etonealbert/frontier-navara-alaskan-latch/INPUT_SHA256.md

# Input SHA-256 checksums

- `input/cad-latch-spec.md` (original Russian specification): `16639eb333ce7da3cb17c0e53108751b8e13a31392efb1666b8e538bc34eb55a`
- `input/cad-photo-atlas.pdf` (English edition supplied by the owner): `2da166d66fd484453dd131d62949d49e78a3da9dffdf473839794cafe3c26b40`

The preceding Russian atlas is available in Git history. Its original ten embedded photos are pixel-identical to the photos on pages 2–11 of the English edition.
