etonealbert/frontier-navara-alaskan-latch/reports/assumptions.md

# Допущения и неподтверждённые зоны V01

V01 — **предварительная модель для примерки**, а не метрологическая копия. Все значения со статусами О, Д и ?
редактируются в [`src/params.py`](../src/params.py); полный автоматически сгенерированный список параметров
со статусами и источниками — [parameters.md](./parameters.md). Измеренные значения тела — [validation.md](./validation.md).

Статусы ТЗ: **У** — владелец; **И** — исходное описание; **О** — оценка; **Д** — допущение; **Р** — расчёт; **?** — неизвестно.

## Редакции

| Дата | Изменение | Основание |
|---|---|---|
| 12.11.2026 | Первая полная модель V01 | ТЗ ред. 2, фотоальбом |
| 13.11.2026 | Отверстия проушин **Ø2,5 → Ø3,1**. По цепи ТЗ §4/§10.2 центр C опущен **7,15 → 6,85** над A (перемычка 2,9 над отверстием сохранена); дуга вершины ушка R4,15 → **R4,45**; развал боковин 8,4° → 6,4°. Остальная геометрия не менялась; зуб относительно C сместился на 0,30 вверх (ΔZ −23,79 → −23,49) | Исправленный замер владельца: прежний Ø2,5 неверен |

## 1. Базы и система координат

| Решение | Статус | Обоснование |
|---|---|---|
| X — ось C; Z — нормаль к A к макушкам проушин; H = Z; +Y — тыльная сторона (рожки, рёбра, зуб), −Y — лицевая (лопатка) | Д (ТЗ §2) | Правая тройка; начало — на A под осью C в плоскости симметрии B |
| A ∥ P (δ = 0°) | Д (ТЗ §2, §10.1) | На фото IMG_4396 линии площадки и лопатки различаются ≈2°; ТЗ задаёт 0° как стартовое |
| **S** — линия выхода верхней грани лопатки (плоскость P) из лицевой плоскости фланца; виртуальная острая кромка (в теле есть галтель R1) | Д (ТЗ §2 требует указать кромку) | Владелец мерил 30,0 «от ступеньки»; верхняя (лицевая) грань — естественная база замера |
| Положение S: 3,5 мм вдоль F от прямой кончиков крылышек (`PADDLE_S_V`) | О | По IMG_4396 и IMG_4391 получается 3,6–3,9; взято 3,5, чтобы корень лопатки 52 мм оставался внутри контура фланца |
| L1 = 30,0 — от S вдоль P до крайней точки свободного торца | У/Д | Как в ТЗ §2 |

## 2. Замыкание H1 и зависимая длина шейки

- H1 = 33,5 измеряется от макушки проушины (Z = 11,3) до **самой нижней точки фланца**. Фланец наклонён на 20°
  верхом к рожкам (+Y), поэтому в V01 нижняя точка — **тыльно-нижняя кромка фланца при X = 0** (со скруглением R0,4).
- Ведущий размер H1 сохраняется точно, поэтому **шейка — зависимое звено**: 3,42 мм по лицевой грани (от нижнего
  лицевого угла площадки до прямой V = 0) и 4,58 мм по тыльной грани — вместо стартовых 5,1 (ТЗ §10.2 разрешает это явно).
  Цепь: 11,3 + 2,5 + 3,42·cos20° + 16,5·cos20° + 3,2·sin20° − 0,11 (скругление) = 33,5.
- **Чувствительность.** На фото нижней кажется лицевая кромка (перспектива или пространственный изгиб, который ТЗ
  запрещает вводить). Если владелец мерил H1 до лицевой кромки, фланец должен стоять на ≈1,0 мм ниже, а шейка
  станет ≈4,5 мм по лицевой грани. **Подтвердить у владельца.**

## 3. Шейка и фланец

| Решение | Статус | Обоснование / последствия |
|---|---|---|
| Шейка и фланец — одна пластина: лицевая грань шейки продолжает лицевую грань фланца | Д | Так на IMG_4391/4396; требует β = α + δ (при иных углах построение останавливается с понятной ошибкой — излом шейки в V01 не реализован) |
| Толщина шейки = толщине фланца **3,2** (исходник: 3,0) | Д, отклонение +0,2 от И | Непрерывная литая пластина без видимой ступени; 0,2 мм ниже точности исходного замера; `NECK_THICKNESS_SPEC` сохранён для справки |
| Ширина шейки 32,68 у площадки → 34,0 у прямой V = 0 (линейно); вогнутые переходы R1,21 → ширина сопряжения **36,0** | И + Р | ТЗ §12.1: «36 — стартовая ширина центрального сопряжения» |
| Контур выпуклой кромки — сплайн через (0; 16,5), (±9; 16,2), **(±18; 14,3)**, **(±26; 9,8)**, (±35; 0) | О/Д | Точки ±18 и ±26 **уточнены** против таблицы ТЗ (13,8 и 8,5) повторной нормировкой силуэта IMG_4397 (на фото ≈14,3–14,8 и ≈9,4–9,9). С табличными точками корень лопатки 52 мм выходит за кромку на ≈1,5 мм, и галтель корня не строится. Исходная таблица оставлена: `FLANGE_CONTOUR_SOURCE = 'spec'` (строится при `PADDLE_S_V = 2,5`, проверено) |
| Кончики крылышек R1 в контуре; острый кончик до скругления вынесен на X = ±36,17, чтобы габарит после R1 был ровно 70,000 | Д + Р | ТЗ §12.2: «сохранять конечный габарит 70 после скругления» |
| Противоположная кромка крылышек — общая прямая V = 0 | Д (ТЗ §12.1) | На IMG_4397 нижние кромки крылышек слегка опускаются к шейке — не воспроизведено |
| Пространственный изгиб пластины — нет | Д (ТЗ §7, §12.1) | |
| Скругления кромок фланца: лицевая R0,5, **тыльная R0,4** | Д | 0,5 → 0,4, чтобы касательная скругления не совпала с нижней линией корня зуба (отступ 0,5) — иначе вырожденная булева операция |
| Тыльное углубление 48 × 2,5 × 1,5, центр V = 5,0, концы R1,25 закрыты, остаток стенки 1,7 | О/Д | ТЗ §12.2; широкое обрамление, маркировка, круглые следы — не моделировались (ТЗ §11) |

## 4. Проушины и площадка

| Решение | Статус | Обоснование / последствия |
|---|---|---|
| Профиль ушка: дуга R4,45 (= перемычка 2,9 + Ø/2) с центром в отверстии + касательные прямые к углам основания 10,5 → развал боковин 6,4° | Д (ТЗ §12.2) | На наложении на IMG_4396 тыльная боковина ближе к вертикали и, похоже, не доходит до торца площадки со стороны рожков на ≈1–1,5 мм — **проверить на образце** |
| Основание ушка заподлицо с торцами площадки | Д (ТЗ §12.2) | |
| Отверстия **Ø3,1** сквозные, соосные; центр C **6,85** над A = 11,3 − (2,9 + 3,1/2); фаска 0,2×45° | У / Р / Д | Ø — исправленный замер владельца 13.11.2026 (в ТЗ Ø2,5 «И» — ошибочно). Центр — расчёт по ТЗ: перемычка 2,9 (И) сохранена, поэтому ось C на 0,30 ниже прежней. Если владелец мерил положение оси, а не перемычку: `LUG_HOLE_CENTER_Z_FIXED = 7.15` (перемычка станет 2,6; вариант строится и проверяется). На IMG_4396 отверстие Ø3,1 совпадает с ободом на фото, но разницу 0,3 мм по высоте перспективное фото не разрешает |
| Галтели корня проушин R0,5 с обеих сторон | Д | Зазор 21,8 сохраняется выше Z = 0,5; ниже внутренняя галтель сужает его ≤0,5 мм с каждой стороны только у самой площадки |
| Площадка — трапеция 32,68 (шейка) → 30,8 (рожки), длина 10,5, толщина 2,5 под A | И | |
| Рожки: центры X = ±9, ширина 2,2, вылет 2,0 за торец в плоскости A, толщина 2,5 (= площадке); продольные кромки R0,4, торец R0,3 | И/О + Д | Торец скруглён одной гладкой петлёй 0,75·R: исходный вариант с тремя галтелями в углу давал дефектную триангуляцию STL |

## 5. Рёбра

- Три ребра: среднее по B и два крайних на **X = ±13,0** (О по IMG_4397 ≈ ±13,2–13,5 и IMG_6560 ≈ ±12,6). Фраза ТЗ
  §12.2 «непосредственно у боковых краёв перехода» на фото выглядит как ≈3 мм внутрь от кромок шейки (примерно по
  линии проушин); при конфликте ТЗ §12 отдаёт приоритет топологии по фото.
- Профиль — треугольная косынка во внутреннем углу «низ площадки — тыльная грань шейки» (угол 110°), катеты 4,5 / 4,5
  вдоль этих граней, толщина 2,0, галтели примыкания R0,5 (О / Д).

## 6. Лопатка

| Решение | Статус | Обоснование |
|---|---|---|
| План: трапеция 52 (на S) → 40 (заготовка у конца), длина 30 от S вдоль P, углы конца R10 | У/И/Д | ТЗ §8, §12.2 |
| Верхняя грань плоская (= P); нижняя — линейное уменьшение толщины 6,0 (у S) → 3,0 (торец) | И / Д | Профиль толщины по фото не определяется; линейный скос — простейший «плавный» |
| Скругление кромок по толщине R1,4 по всему контуру верхней и нижней граней | Д (ТЗ: R1,5) | При торце 3,0 два скругления R1,5 вырождают торец; 1,4 оставляет плоский поясок 0,2 |
| Галтель корня R1,0 | Д | У нижних углов (|X| > 23,5) сливается со скруглением кромки фланца; за контур фланца материал не выходит (проверено) |
| Выемка для пальцев, микрофактура — нет | Д (ТЗ §8, §12.2) | |

## 7. Зуб-защёлка — критическая неподтверждённая зона

| Решение | Статус | Обоснование / риск |
|---|---|---|
| Ширина 17,5 симметрично B | И | |
| Направление: основной участок параллелен P (γ = 0°), без загиба и крюка | У (качественно) / Д (0°) | Проверено: угол между прямой гранью зуба и P = 0,000° |
| **Прямая грань — верхняя** (к +Z), нижняя — скос | Д | На IMG_4391/4396 верх остатка зуба почти параллелен лопатке, низ скошен; на наложении верх остатка совпадает с прямой гранью V01. Вариант `TOOTH_FLAT_FACE = 'bottom'` строится |
| Нижняя граница корня R0 — 0,5 мм вдоль F от вершины выпуклой кромки (X = 0) | Д (ТЗ §12.3 п.1) | |
| Толщина 5,2 у R0 → 2,0 у конца (линейный скос нижней грани) | И/Д + И | |
| Вылет 10,0 вдоль P от тыльной плоскости фланца на линии корня прямой грани (T0) до торца | И | На образце зуб обломан (видимый остаток ≈3,5 мм) — 10,0 не подтверждено |
| Корневая галтель R1,0 по верхней линии корня (корень прямой грани); кромки конца R0,3 | Д | Галтель стоит на стороне растяжения при нажатии на прямую грань к −Z; **находится ли она вне зоны контакта — неизвестно**, т.к. зона контакта не измерена |
| Сплошной зуб; две полости оригинала не воспроизведены | Д (ТЗ §12.3 п.4) | Сплошной зуб жёстче полого — усилие защёлкивания может отличаться |
| **Удерживающая ступенька не задана** | ? | Механизм оставлен параметрическим: `TOOTH_STEP_ENABLED`, `TOOTH_STEP_FROM_ROOT`, `TOOTH_STEP_DEPTH`, `TOOTH_STEP_WALL_DEG` (по умолчанию выключено; значения — заглушки только для проверки механизма, вариант строится) |

Положение зуба относительно оси C (для проверки по ответной части): корень прямой грани T0 — ΔY = −6,99,
ΔZ = −23,49; конец — ΔY = +3,01, ΔZ = −23,49; середина корня — на 26,1 ниже C и на 7,9 в сторону лопатки
(фото-оценка ТЗ §12.3: ≈26 и 5–6 мм с неопределённостью в несколько миллиметров).

## 8. Технические допущения построения

- Корни лопатки и зуба заглублены в пластину (1,2 и 1,0 мм) для надёжного объединения; пластина шейки подрезана
  плоскостью низа площадки.
- Скругления выполняются после объединения с явным выбором рёбер; **любой сбой скругления останавливает построение**
  (без «тихих» пропусков) — журнал в [build_info.json](./build_info.json).

## 9. Сводка неподтверждённого (что нужно для V02)

| Что | Статус | Что нужно |
|---|---|---|
| Удерживающая грань зуба: положение относительно C, высота, угол, длина рабочего участка | ? | Замер ответного зацепа или примерка V01 |
| Внутренние полости зуба | ? | Замеры, если нужна копия по гибкости |
| Точка замера H1 (тыльная или лицевая нижняя кромка) | Д | Подтверждение владельца (влияет на положение фланца ≈1 мм) |
| Высота оси C над площадкой: 6,85 по расчёту из перемычки 2,9 (И) и Ø3,1 (У) | Р | Замер перемычки «макушка → край отверстия» или прямой замер центра отверстия над площадкой |
| Ø оси и её посадка в отверстиях Ø3,1 | ? | Замер оси, примерка |
| Форма и длина основания ушка | И/?/Д | Замер на образце |
| Углы α, β (110 ± 5°), δ | О/Д | Замер на образце |
| Положение S, профиль толщины лопатки, торец 3,0 | О/Д | Замер на образце |
| Промежуточные точки контура фланца, положение и профиль рёбер | О/Д | Обмер тыльной стороны |
| Материал, прочность, теплостойкость, допуски печати | не определены | Выбор материала и испытания прототипа |
