etonealbert/frontier-navara-alaskan-latch/reports/parameters.md

# Параметры V01 (сгенерировано из `src/params.py` скриптом `src/validate.py`)

Статусы ТЗ: **У** — владелец; **И** — исходное описание; **О** — оценка; **Д** — допущение; **Р** — расчёт; **?** — неизвестно. Изменять значения — только в `src/params.py`, затем `src/run_all.py`.

| Параметр | Значение | Статус | Источник | Описание |
|---|---|---|---|---|
| `H1_OVERALL` | 33.5 | У | ТЗ §3, IMG_4394 | Габарит вдоль H(=Z): макушка проушины → самая нижняя кромка фланца; лопатка не входит; ведущий размер |
| `H2_FLANGE` | 16.5 | У | ТЗ §3, §7, IMG_4395 | Собственная высота фланца вдоль F: прямая V=0 кончиков крылышек → вершина выпуклой кромки |
| `H3_LUG` | 11.3 | У | ТЗ §3, §4 | Высота проушины от A до макушки по нормали к A |
| `L1_PADDLE` | 30.0 | У/Д | ТЗ §2, §3, §8 | Длина лопатки вдоль P от линии S до крайней точки свободного торца |
| `ALPHA_DEG` | 110.0 | О | ТЗ §10.1, IMG_4396 | α: луч вдоль P к свободному концу лопатки ↔ луч вдоль фланца к его верхней кромке (тупой) |
| `BETA_DEG` | 110.0 | О | ТЗ §10.1, IMG_4396 | β: луч по площадке к рожкам ↔ луч по шейке к фланцу (тупой) |
| `GAMMA_DEG` | 0.0 | Д (У — качественно) | ТЗ §9, §10.1 | γ: основное направление зуба ↔ P; >0 — конец зуба поднимается к +Z |
| `DELTA_DEG` | 0.0 | Д | ТЗ §2, §10.1 | δ: A ↔ P; >0 — свободный конец лопатки поднимается к +Z |
| `LUG_HOLE_D` | 3.1 | У | владелец, исправленный замер 13.11.2026 (в ТЗ §4: Ø2,5 «И» — ошибочно) | Диаметр соосных сквозных отверстий под ось C |
| `LUG_THICKNESS` | 3.0 | И | ТЗ §4 | Толщина каждой проушины вдоль X |
| `LUG_INNER_GAP` | 21.8 | И | ТЗ §4 | Чистый зазор между внутренними плоскими гранями проушин |
| `LUG_TOP_TO_HOLE_EDGE` | 2.9 | И | ТЗ §4 | Перемычка: от макушки до ближайшего края отверстия; задаёт высоту центра C (Р, ТЗ §4/§10.2) |
| `LUG_HOLE_CENTER_Z_FIXED` | не задано | Д | — | None — центр C по цепи ТЗ: Z = H3 − (перемычка + Ø/2). Число — центр C жёстко на этой высоте над A (напр. 7.15 — положение до исправления Ø); перемычка тогда = H3 − Z − Ø/2 |
| `LUG_BASE_LENGTH` | 10.5 | И/? | ТЗ §4, §12.2 | Длина основания ушка вдоль Y; основание заподлицо с торцами площадки (Д) |
| `LUG_HOLE_FROM_FRONT_END` | 5.25 | Д | ТЗ §12.2 | Центр отверстия от лицевого торца основания (середина основания) |
| `LUG_ROOT_FILLET` | 0.5 | Д | ТЗ §12.2 | Галтель корня проушин (на A) |
| `LUG_HOLE_CHAMFER` | 0.2 | Д | ТЗ §12.2 | Притупление кромок отверстий 0,2×45° |
| `PAD_WIDTH_HORN_END` | 30.8 | И | ТЗ §5 | Ширина площадки (X) у торца со стороны рожков |
| `PAD_WIDTH_NECK_END` | 32.68 | И | ТЗ §5 | Ширина площадки (X) у перехода к шейке |
| `PAD_LENGTH` | 10.5 | И | ТЗ §5 | Расстояние между торцами площадки в плоскости A (Y) |
| `PAD_THICKNESS` | 2.5 | И | ТЗ §5 | Толщина площадки по нормали к A (под A) |
| `HORN_PITCH` | 18.0 | И | ТЗ §5 | Межцентровое расстояние рожков по X (центры ±9 — Р) |
| `HORN_PROTRUSION` | 2.0 | И (направление Д) | ТЗ §5, §12.2 | Вылет рожков за торец площадки в плоскости A (+Y) |
| `HORN_WIDTH` | 2.2 | О | ТЗ §5 | Ширина рожка по X |
| `HORN_THICKNESS` | 2.5 | О | ТЗ §5 | Толщина рожка (в пределах толщины площадки) |
| `HORN_EDGE_FILLET` | 0.4 | Д | ТЗ §12.2 | Скругление открытых продольных кромок рожков; торец — одной гладкой петлёй 0,75×R (0,3), чтобы не было трёхрёберных угловых сопряжений |
| `NECK_WIDTH_AT_PAD` | 32.68 | И | ТЗ §6 | Ширина шейки у площадки |
| `NECK_WIDTH_AT_FLANGE` | 34.0 | И | ТЗ §6 | Ширина шейки у фланца (на прямой V=0) |
| `NECK_LENGTH_START` | 5.1 | И/Д | ТЗ §6, §10.2 | Справочная стартовая длина; итоговая длина — Р из замыкания H1 (см. отчёт) |
| `NECK_THICKNESS_SPEC` | 3.0 | И | ТЗ §6 | Толщина стенки шейки по исходнику; в V01 шейка — продолжение пластины фланца (см. FLANGE_THICKNESS) |
| `NECK_JUNCTION_WIDTH` | 36.0 | И/Д | ТЗ §12.1 | Ширина центрального сопряжения шейки с прямой кромкой V=0 (вогнутые переходы) |
| `NECK_PAD_OVERLAP` | 2.5 | Д (техн.) | — | Технический запас контура шейки выше угла площадки перед подрезкой плоскостью низа площадки |
| `RIB_THICKNESS` | 2.0 | О | ТЗ §6 | Толщина каждого ребра по X |
| `RIB_LEG_ALONG_PAD` | 4.5 | О | ТЗ §6 | Катет ребра вдоль низа площадки |
| `RIB_LEG_ALONG_NECK` | 4.5 | О | ТЗ §6 | Катет ребра вдоль тыльной грани шейки |
| `RIB_OUTER_X` | 13.0 | О | IMG_4397, IMG_6560 (ТЗ §12.2: «у боковых краёв») | Положение средних плоскостей крайних рёбер ±X; среднее ребро по B |
| `RIB_ROOT_FILLET` | 0.5 | Д | ТЗ §12.2 | Галтели примыкания рёбер |
| `FLANGE_WIDTH` | 70.0 | И | ТЗ §7 | Полная ширина от кончика до кончика (после скругления кончиков) |
| `FLANGE_THICKNESS` | 3.2 | И | ТЗ §7 | Толщина пластины фланца (и шейки в V01) по нормали |
| `FLANGE_CONTOUR_SPEC` | (0, 16.5); (9, 16.2); (18, 13.8); (26, 8.5); (35, 0) | О/Д | ТЗ §12.1 | Исходная таблица опорных точек выпуклой кромки (X, V) |
| `FLANGE_CONTOUR_V01` | (0, 16.5); (9, 16.2); (18, 14.3); (26, 9.8); (35, 0) | О/Д | ТЗ §12.1 + повторная нормировка силуэта IMG_4397 | Опорные точки V01: промежуточные (±18, ±26) скорректированы по фото, габариты 70/16,5 сохранены |
| `FLANGE_CONTOUR_SOURCE` | v01 | Д | — | Какой набор точек применять: 'v01' или 'spec' |
| `FLANGE_TIP_RADIUS` | 1.0 | Д | ТЗ §12.2 | Скругление кончиков крылышек в контуре |
| `FLANGE_EDGE_FILLET_FRONT` | 0.5 | Д | ТЗ §12.2 | Скругление наружных кромок лицевой стороны |
| `FLANGE_EDGE_FILLET_BACK` | 0.4 | Д | ТЗ §12.2 (0,5 → 0,4) | Скругление кромок тыльной стороны; уменьшено, чтобы не совпадать с линией корня зуба (отступ 0,5) |
| `FLANGE_FRONT_OFFSET` | 0.0 | Д | IMG_4391/4396 | Смещение лицевой плоскости фланца от лицевой грани шейки по N (0 — соосны, как на фото) |
| `GROOVE_LENGTH` | 48.0 | О | ТЗ §7, §12.2 | Длина тыльного углубления (с полукруглыми концами) |
| `GROOVE_WIDTH` | 2.5 | О | ТЗ §7, §12.2 | Ширина углубления (концы R1,25) |
| `GROOVE_DEPTH` | 1.5 | О | ТЗ §7, §12.2 | Глубина углубления от тыльной плоскости (дно 1,7) |
| `GROOVE_CENTER_V` | 5.0 | О/Д | ТЗ §12.2 | Центр углубления по V от прямой кончиков крылышек |
| `PADDLE_WIDTH_ROOT` | 52.0 | И | ТЗ §8 | Ширина у основания (на линии S) |
| `PADDLE_WIDTH_TIP` | 40.0 | И/Д | ТЗ §8, §12.2 | Ширина трапециевидной заготовки у конца до скруглений |
| `PADDLE_CORNER_RADIUS` | 10.0 | И/Д | ТЗ §8 | Радиус двух углов свободного конца в плане |
| `PADDLE_THICKNESS_ROOT` | 6.0 | И | ТЗ §8 | Толщина у основания (у S) по нормали к P |
| `PADDLE_THICKNESS_TIP` | 3.0 | Д | ТЗ §8, §12.2 | Толщина свободного торца |
| `PADDLE_EDGE_FILLET` | 1.4 | Д | ТЗ §12.2 (R1,5 → 1,4) | Скругление кромок лопатки по толщине; 1,4 вместо 1,5 — при торце 3,0 R1,5×2 вырождает торец |
| `PADDLE_S_V` | 3.5 | О | IMG_4396, IMG_4391 | Положение S: расстояние вдоль F от прямой V=0 до линии выхода верхней грани лопатки из лицевой плоскости фланца |
| `PADDLE_ROOT_FILLET` | 1.0 | Д | — | Галтель примыкания лопатки к лицевой плоскости фланца |
| `PADDLE_EMBED_DEPTH` | 1.2 | Д (техн.) | — | Заглубление корня лопатки в пластину для надёжного объединения |
| `TOOTH_WIDTH` | 17.5 | И | ТЗ §9 | Полная ширина зуба по X, симметрично B |
| `TOOTH_LENGTH` | 10.0 | И | ТЗ §9, §12.3 | Вылет вдоль направления зуба от тыльной плоскости фланца (линия корня прямой грани) до конца |
| `TOOTH_THICKNESS_ROOT` | 5.2 | И/Д | ТЗ §9, §12.3 | Максимальная толщина у корня по нормали к P |
| `TOOTH_THICKNESS_TIP` | 2.0 | И | ТЗ §9 | Толщина свободного конца |
| `TOOTH_FLAT_FACE` | top | Д | ТЗ §12.3 п.2, IMG_4391 | Какая продольная грань прямая и параллельна P: 'top' (к +Z) или 'bottom'; противоположная — скос |
| `TOOTH_ROOT_EDGE_OFFSET` | 0.5 | Д | ТЗ §12.3 п.1 | Отступ вдоль F от выпуклой кромки (X=0) до ближайшей границы корня зуба |
| `TOOTH_ROOT_FILLET` | 1.0 | Д | ТЗ §12.3 п.5 | Корневая галтель у прямой грани (вне зоны контакта) |
| `TOOTH_TIP_FILLET` | 0.3 | Д | ТЗ §9, §12.3 п.5 | Притупление кромок свободного конца |
| `TOOTH_EMBED_DEPTH` | 1.0 | Д (техн.) | — | Заглубление тела зуба в пластину для объединения |
| `TOOTH_SOLID` | True | Д | ТЗ §9, §12.3 п.4 | Сплошной зуб; две полости оригинала не воспроизводятся |
| `TOOTH_STEP_ENABLED` | False | ? | ТЗ §9, §12.3 п.3 | Включить удерживающую ступеньку на прямой грани (по умолчанию выключено) |
| `TOOTH_STEP_FROM_ROOT` | 6.0 | ? | заглушка | Положение стенки ступеньки от линии корня вдоль зуба |
| `TOOTH_STEP_DEPTH` | 0.8 | ? | заглушка | Глубина ступеньки от прямой грани |
| `TOOTH_STEP_WALL_DEG` | 90.0 | ? | заглушка | Угол стенки ступеньки к P (90 — перпендикулярно) |
| `STL_TOLERANCE` | 0.01 | Д | — | Линейный допуск триангуляции STL, мм |
| `STL_ANGULAR_TOLERANCE` | 0.1 | Д | — | Угловой допуск триангуляции STL, рад |

## Расчётные величины (Р)

| Величина | Значение, мм/° | Как получена |
|---|---:|---|
| Центр отверстия C над A | 6.850 | H3 − (перемычка 2,9 + Ø/2) |
| Радиус дуги вершины ушка | 4.450 | H3 − Z_C (дуга с центром в отверстии через макушку, Д) |
| Перемычка над отверстием | 2.900 | R − Ø/2 |
| Внутренние грани проушин X | 10.900 | ±зазор/2 |
| Средние плоскости проушин X | 12.400 | ±(зазор + толщина)/2 |
| Наружный размах проушин | 27.800 | зазор + 2·толщина |
| Нижний край отверстия над A | 5.300 | центр − Ø/2 |
| Остаток площадки за проушинами | 1.500 | (30,8 − 27,8)/2 |
| Целевой низ фланца Z | -22.200 | H3 − H1 |
| Длина шейки по лицевой грани | 3.420 | замыкание H1 (вместо стартовых 5,1) |
| Длина шейки по тыльной грани | 4.584 | от низа площадки до прямой V=0 |
| Радиус вогнутого перехода шейки | 1.211 | ширина сопряжения 36 при V=0 |
| X острого кончика до скругления R1 | 36.172 | итерация: габарит 70,000 после R1 |
| Развал боковин проушины | 6.429 | касательные от углов основания к дуге R4,45 |
| S: Y | -7.617 | лицевая плоскость фланца на V = PADDLE_S_V |
| S: Z (= плоскость P) | -9.002 | то же |
| Корень прямой грани зуба T0: Y | -6.992 | от оси C (Y=0) |
| Корень прямой грани зуба T0: Z | -16.643 | Z оси C = 6,85 |
| Нижняя линия корня зуба R0: Y | -8.885 | 0,5 вдоль F от выпуклой кромки |
| Нижняя линия корня зуба R0: Z | -21.843 |  |
| Конец зуба: Y | 3.008 | T0 + 10 вдоль P |
| Объём тела, мм³ | 11008.366 | build123d |
