etonealbert/frontier-navara-alaskan-latch/input/cad-latch-spec.md

# Техническое задание: восстановление ручки-защёлки по образцу

Редакция 2 от 12 ноября 2026 года — с учётом пяти дополнительных фотографий и разрешения владельца использовать приближённые значения. Все линейные размеры — в миллиметрах, углы — в градусах.

## 1. Назначение и статус документа

Построить параметрическую 3D-модель ручки-защёлки по приложенным фотографиям и размерам. Сохранить посадочную геометрию, внешний силуэт, положение оси вращения, упоров и рабочего зуба. Повреждённый зуб восстановить; трещины, сколы, заусенцы и следы износа не копировать.

Проверены исходное описание `данные-модели.md` и десять фотографий, включая разметку размеров на IMG_4394.jpeg и IMG_4395.jpeg и углов на IMG_4396.jpeg. Сам CAD-файл не предоставлен: выполнена проверка описания, фотографий и размерных зависимостей, а не проверка готовой 3D-модели.

**Документ завершён как рабочее ТЗ для построения первой полной CAD-модели с явно заданными приближениями.** Владелец разрешил оценить недостающую геометрию по фото. Направления основных габаритов уточнены, для углов и недостающих мелких элементов ниже назначены стартовые параметры. Точность посадки и профиль утраченной части зуба по фотографиям не подтверждены: перед окончательным изготовлением нужна проверка по ответной детали или примерка прототипа. Не выдавать модель за точную метрологическую копию.

### Статусы размеров

- **У** — задано или уточнено владельцем; считать заданным номиналом. Это не означает нулевой допуск.
- **И** — перенесено из исходного ТЗ; способ измерения и точность не подтверждены.
- **О** — оценка из исходного ТЗ или по фотографиям; не использовать как точный посадочный размер.
- **Д** — принятое рабочее допущение для завершения модели; это не измерение оригинала.
- **Р** — расчёт из других размеров; действителен только при явно указанных условиях.
- **?** — фактический размер оригинала неизвестен; для первой модели применять допущение из раздела 12, если оно задано.

Приоритет: новые замеры владельца → проверенные замеры образца → исходные размеры → фотографии и оценочные значения. Не изменять точные размеры ради совпадения с перспективой фотографии.

## 2. Термины, стороны и базы

Деталь состоит из двух петлевых проушин, площадки с двумя небольшими упорами («рожками»), переходной шейки с рёбрами, широкого опорного фланца с боковыми «крылышками», нажимной лопатки и центрального зуба на обратной стороне фланца.

- **Лицевая сторона** — сторона, в которую выступает широкая лопатка для пальцев.
- **Тыльная сторона** — сторона зуба-защёлки и видимых усилительных рёбер.
- **A** — плоская поверхность площадки с рожками, от которой измерена высота проушины 11,3.
- **B** — средняя плоскость симметрии между двумя проушинами и крылышками. Симметрию принять для предварительной модели; проверить на образце.
- **C** — общая ось двух отверстий под ось вращения.
- **P** — условная основная плоскость лопатки, определяемая по её широкому прямому участку, без закруглённого торца и местного утолщения у корня.
- **S** — ступенька фланца, от которой владелец измерил длину лопатки 30,0. Конкретную кромку ступеньки отметить на эскизе.

Для CAD удобно направить X вдоль оси C (поперёк ширины детали), Z перпендикулярно A в сторону макушек проушин; Y дополнить до правой системы. Начало координат — проекция пересечения C и B на A. Не считать направление экранной вертикали фотографии осью Z.

### Уточнение баз по новым фотографиям

- **H** — направление общего габарита 33,5: от макушки проушины к самой нижней кромке фланца между горизонтальными красными линиями IMG_4394.jpeg. Это габарит в боковой проекции, а не длина ломаной по поверхности.
- **F** — основное направление фланца на боковом виде: от его верхнего закруглённого края к нижнему. Размер 16,5 на IMG_4395.jpeg трактовать как расстояние между двумя крайними опорными линиями, измеряемое вдоль F, приблизительно перпендикулярно красным наклонным линиям. Красные линии нарисованы от руки, их наклон не является измеренным углом.
- В первой модели принять H совпадающим с Z, а A приблизительно параллельной P (**Д**). На фото эти направления близки, но строгое равенство не доказано. Сохранить A/P отдельным параметром, стартовое отклонение 0°.
- Направление F наклонено примерно на 20° к H при выбранных ниже углах 110°. Фланец должен наклоняться в ту же сторону, что на боковом фото, а не зеркально.
- Размер 30,0 принять прямым размером вдоль P от линии выхода лопатки из ступеньки S до крайней точки свободного торца (**У** для величины, **Д** для строгой CAD-интерпретации).

## 3. Главные уточнённые размеры

| Обозначение | Размер | Статус | Что именно задано |
| --- | ---: | --- | --- |
| H1 | 33,5 | У | Габарит вдоль H между макушкой проушины и нижним краем фланца по IMG_4394.jpeg. Лопатка в этот размер не входит. |
| H2 | 16,5 | У | Собственный размер фланца вдоль F между его крайними кромками по IMG_4395.jpeg. Это не толщина и не вертикальная проекция. |
| H3 | 11,3 | У | Высота проушины от A до макушки по нормали к A. Заменяет старую оценку 10,5. |
| L1 | 30,0 | У/Д | От ступеньки S до свободного края; в первой модели измерять прямолинейно вдоль P. Заменяет 28,5–30,0. |

**Не складывать 33,5 и 30,0 для получения общего габарита детали:** это размеры разных участков и направлений.

## 4. Петлевые проушины — 2 шт.

Две плоские проушины с округлой вершиной и соосными сквозными отверстиями. Термин «параболическое ушко» описывает внешний вид, но не задаёт математическую параболу.

| Параметр | Размер | Статус / указание |
| --- | ---: | --- |
| Высота от A до макушки | 11,3 | У |
| Диаметр отверстий | Ø2,5 | И; проверить по неповреждённой части отверстий и ответной оси |
| Толщина каждой проушины вдоль X | 3,0 | И |
| Чистый зазор между внутренними плоскими гранями | 21,8 | И; не межосевое расстояние |
| Габарит по наружным граням | 27,8 | Р: 21,8 + 2 × 3,0 |
| Расстояние между средними плоскостями проушин | 24,8 | Р: 21,8 + 3,0 |
| От макушки до ближайшего верхнего края отверстия | 2,9 | И; считать размером по высоте, если владелец подтвердит такой способ измерения |
| От макушки до центра отверстия | 4,15 | Р: 2,9 + 2,5 / 2; это расстояние, а не автоматически радиус внешнего контура |
| Высота центра C над A | 7,15 | Р: 11,3 − 4,15; при одинаковом направлении замеров 11,3 и 2,9 |
| Длина основания ушка в его профильной плоскости | около 10,5 | И/?: исходное описание связывает основание с длиной площадки; проверить отдельно |
| Наружная фаска / углубление вокруг отверстия | не задано | На фото край отверстия неоднороден; не принимать повреждение или блик за точную цековку |

При симметрии по B внутренние грани проушин находятся на X = ±10,9, наружные — на X = ±13,9, средние плоскости — на X = ±12,4.

**Не назначать внешний R4,15 только по положению отверстия.** Полукруг радиуса 4,15, концентричный отверстию, допустим лишь как отдельно подтверждённая аппроксимация. Его ширина была бы 8,30; переход к основанию 10,5 потребует отдельного контура. Положение отверстия вдоль Y, профиль вершины и радиусы у корня для первой модели назначить по разделу 12; это допущения, а не новые замеры.

## 5. Площадка под проушинами и рожки

| Параметр | Размер | Статус / указание |
| --- | ---: | --- |
| Ширина торца со стороны рожков | 30,8 | И |
| Ширина у перехода к шейке | 32,68 | И; сотые сохранены из исходника, точность до 0,01 не подтверждена |
| Расстояние между этими торцами в плоскости A | 10,5 | И; не путать с высотой проушин 11,3 |
| Толщина площадки по нормали к A | 2,5 | И |
| Количество рожков | 2 | Видны на фото |
| Межцентровое расстояние рожков по ширине | 18,0 | И |
| Выступание рожков за торец площадки | 2,0 | И; в первой модели — в плоскости A за торец со стороны рожков (Д) |
| Ширина каждого рожка | около 2,2 | О |
| Толщина рожков | около 2,5 | О; предположительно в пределах толщины площадки |

Рожки на фотографиях имеют смягчённые кромки; не задавать острые прямоугольные блоки как подтверждённую форму. При симметричном размещении их центры X = ±9,0 (условный расчёт). Скругления и положение основания проушин для первой модели принять по разделу 12.

## 6. Переходная шейка и рёбра

| Параметр | Размер | Статус / указание |
| --- | ---: | --- |
| Ширина у площадки | 32,68 | И |
| Ширина у фланца | 34,0 | И |
| Длина наклонного участка | 5,1 | И/Д; стартовая длина по прямому наклонному участку; подчинить замыканию H1 по разделу 10 |
| Толщина стенки | 3,0 | И; измерять по нормали к стенке |
| Угол площадка–шейка | около 110° | О; оценка по IMG_4396.jpeg, ориентировочный диапазон 105–115°, старт CAD 110°. Определение лучей — раздел 10. |
| Число рёбер | 3 | Соответствует видимому расположению на тыльных фото: два крайних и одно среднее |
| Толщина каждого ребра | около 2,0 | О |
| Размеры сторон профиля ребра | около 4,5 × 4,5 | О; не считать автоматически катетами прямоугольного треугольника |

На IMG_6560.JPG и IMG_6561.JPG видны три усиления перехода. Точные профили, положения по ширине, длины примыкания и корневые скругления не заданы. Шейку делать зависимой от общей высоты 33,5: размер 5,1 считать стартовым, а не вторым жёстким ограничением. Правило замыкания приведено в разделе 10.

## 7. Опорный фланец с крылышками

Фланец — широкая фигурная пластина с боковыми крылышками и криволинейной наружной кромкой. Описание «трапеция» допустимо лишь для грубой формы: прямолинейная трапеция не передаёт видимый контур. Кривизну кромки и возможный пространственный изгиб пластины задавать раздельно.

| Параметр | Размер | Статус / указание |
| --- | ---: | --- |
| Полная ширина от кончика до кончика | 70,0 | И; прямой габарит, не длина вдоль дуги |
| Высота фланца вдоль F | 16,5 | У; между крайними кромками по IMG_4395.jpeg |
| Размер «малой грани» из исходника | 36,0 | И/?; отметить конкретный отрезок на виде фланца |
| Толщина пластины | 3,2 | И; не смешивать с высотой 16,5 |
| Радиус из исходного описания | R27 — исключить из ограничений | Отклонён как неподтверждённый; контур строить сплайном по разделу 12 |
| Высота сегмента из исходного описания | около 15,5 | О; не использовать вместо нового размера 16,5; принадлежность сегменту не подтверждена |
| Длина тыльного продолговатого углубления | около 48 | О |
| Ширина углубления | около 2,5 | О |
| Глубина углубления | около 1,5 | О |

На тыльных фотографиях виден вытянутый рельеф/углубление вдоль фланца. Одних фотографий недостаточно, чтобы однозначно задать его поперечное сечение как прямоугольный паз. Проверить, где дно, где окружающий бортик, как оформлены концы и как оно расположено относительно зуба.

**Проверка радиуса:** окружность R27 имеет диаметр 54, поэтому хорда 70 для неё невозможна. Если R27 относится только к локальной дуге, противоречия может не быть — эту дугу нужно обозначить. Для отдельной круговой дуги с хордой 70 и стрелой 16,5 расчётный радиус был бы R = 70² / (8 × 16,5) + 16,5 / 2 ≈ 45,37. Это только проверочный пример, **не назначение R45,37 детали**: высота фланца 16,5 пока не подтверждена как стрела именно этой дуги.

Для первой модели использовать новый тыльный вид IMG_4397.jpeg и нормированные точки раздела 12. Не требовать от всего внешнего контура одного постоянного радиуса. На IMG_4393.jpeg видна дугообразная проекция кромки, но её нельзя однозначно разделить на контур и пространственный изгиб; произвольный дополнительный изгиб пластины не вводить.

## 8. Нажимная лопатка

Широкая цельная лопатка с гладкой общей формой, сужением к свободному краю, закруглёнными углами и сглаженным торцом. На фото лицевая поверхность имеет мелкую фактуру; слово «гладкая» не означает обязательное отсутствие этой фактуры. Для базовой CAD-модели микрофактуру не воспроизводить.

| Параметр | Размер | Статус / указание |
| --- | ---: | --- |
| Длина от ступеньки S до свободного края | 30,0 | У/Д; вдоль P, как определено в разделе 2 |
| Ширина у основания | 52,0 | И |
| Ширина у свободного конца | 40,0 | И/Д; в первой модели — ширина заготовки до скруглений |
| Радиус двух углов свободного конца | R10,0 | И/Д; в первой модели — радиус контура в плоскости лопатки |
| Толщина у основания | 6,0 | И; не распространять автоматически на всю длину |
| Угол к фланцу | около 110° | О; диапазон оценки 105–115°, старт CAD 110°; лучи определены в разделе 10 |
| Толщина свободного торца | 3,0 | Д; стартовое значение, не замер |
| Выемка для пальцев / бортик с внутренней стороны | не заданы | В исходнике заявлены, но имеющиеся ракурсы не позволяют восстановить профиль и глубину |

Плавное уменьшение толщины к краю сохранить; стартовый профиль задан в разделе 12. Оба угла около 110° оценены независимо по прямым контурам, а не по красным дугам. В CAD хранить их отдельными параметрами; дополнительный острый угол около 70° описывает те же пересекающиеся прямые, но другие лучи.

## 9. Центральный зуб-защёлка — критическая функциональная геометрия

**Основное требование владельца: зуб не должен быть сильно загнут. Его основной продольный участок почти прямой и практически параллелен плоскости P нажимной лопатки. Не моделировать высокий крюк или заметно поднятый/опущенный конец.**

Зуб выходит с тыльной стороны фланца, по центру ширины. Лопатка выступает с лицевой стороны. «Параллелен лопатке» описывает ориентацию продольного участка зуба в боковом сечении; это не означает совпадение плоскостей, одинаковую высоту или вылет в ту же сторону.

Для предварительной модели принять угол основного направления зуба к P равным 0° как **модельное допущение**, а не измеренный угол. Оставить его отдельным параметром для корректировки после измерения. Местный клин/скос рабочей поверхности и ступенька зацепа не должны превращаться в загиб всего зуба.

| Параметр | Размер | Статус / указание |
| --- | ---: | --- |
| Полная ширина зуба по X | 17,5 | И |
| Полный восстановленный вылет | 10,0 | И; номинал из исходника, на повреждённом образце не подтверждён; отсчитывать от согласованной тыльной поверхности корня до восстановленного конца |
| Максимальная толщина | 5,2 | И/Д; в первой модели назначить у корня; реальная удерживающая ступенька не восстановлена |
| Минимальная толщина у конца | 2,0 | И; не выполнять математически острое лезвие |
| Угол основного участка к P | практически 0° | У — качественное требование; точное значение и допустимое отклонение не заданы |
| Положение рабочей удерживающей грани относительно C | не задано | ? — обязательный размер для работоспособности |
| Высота и угол удерживающей ступеньки | не заданы | ? |
| Радиусы/фаски рабочего конца | R0,3 | Д; только стартовое притупление |

В IMG_6560.JPG и IMG_6561.JPG видны две полости с центральным разделением и повреждённая область зуба. Внешний вид повреждения не позволяет точно восстановить утраченную контактную поверхность. Простого клина 10 × 17,5 с толщинами 5,2 и 2,0 недостаточно, чтобы гарантировать правильное зацепление.

Сначала построить внешний функциональный контур и проверить его по ответной детали. Полости исходной детали не удалять автоматически: их назначение и влияние на работу не установлены. В разделе 12 для первой реконструкции выбран сплошной вариант; перед применением проверить свободное пространство и требуемую податливость. Предложенные в исходнике корневые галтели R1,0–1,5 также являются вариантом доработки, а не измеренной геометрией; они не должны заходить в контактную зону.

Материал, причина поломки, увеличение прочности «в 4–5 раз» и обещание «больше никогда не отломится» по данным фотографиям не установлены. Эти утверждения исключены из требований.

## 10. Оценка углов и проверка размерных цепей

### 10.1. Как определены углы

Оценка выполнена по прямым участкам контура IMG_4396.jpeg, а не по ручным красным стрелкам. Оба угла — в боковом сечении, перпендикулярном оси C.

| Параметр | Лучи, образующие именно тупой угол | Оценка / значение для CAD |
| --- | --- | --- |
| α, лопатка–фланец | Из их условного пересечения: первый луч вдоль P к свободному концу лопатки (влево на фото); второй вдоль фланца к его верхнему краю/проушинам (вверх-вправо) | По выбранным прямым около 111°; для CAD 110°, диапазон визуальной оценки 105–115° |
| β, площадка–шейка | Из перехода площадка–шейка: первый луч по площадке к рожкам (вправо на фото); второй по шейке к фланцу (вниз-влево) | По выбранным прямым около 110°; для CAD 110°, диапазон визуальной оценки 105–115° |
| γ, основное направление зуба–P | Между продольным направлением тела зуба и P; местный скос не учитывается | Для CAD 0° по указанию владельца; возможное отклонение по фото количественно надёжно не определяется |
| δ, A–P | Между площадкой и основным прямым участком лопатки | Для CAD 0° как допущение; на фото близки к параллельным |

Для воспроизводимости оценки: на изображении IMG_4396.jpeg размером 1170 × 1490 вручную выбраны участки лопатки (200,893)–(610,878), фланца (590,1130)–(697,824), площадки (680,711)–(891,695), шейки (638,822)–(671,705). Координаты — пиксели от левого верхнего угла. Угол между направлениями соответствующих лучей рассчитан скалярным произведением. Выбор границ приблизительный; скругления исключались насколько позволяет изображение. Полученные 111° и 110° — углы проекции, не точные пространственные измерения.

Диапазон 105–115° — оценочная неопределённость для реконструкции, **не производственный допуск**. В первой модели установить α = β = 110°. Эти значения согласуются с общим силуэтом и прежним предположением владельца, но не гарантируют посадку.

### 10.2. Численная согласованность

| Проверка | Результат | Применение |
| --- | --- | --- |
| Наружная ширина проушин | 21,8 + 2 × 3,0 = 27,8 | Согласовано при плоских параллельных стенках |
| Между средними плоскостями проушин | 21,8 + 3,0 = 24,8 | Согласовано |
| Центр отверстия ниже макушки | 2,9 + 2,5 / 2 = 4,15 | Расстояние, не доказанный радиус |
| Центр отверстия над A | 11,3 − 4,15 = 7,15 | Заменяет прежнюю оценку 6,3 |
| Нижний край отверстия над A | 7,15 − 1,25 = 5,90 | Расчёт при сохранении Ø2,5 и перемычки 2,9 |
| Остаток площадки за проушинами | (30,8 − 27,8) / 2 = 1,5 | При симметрии и одинаковом сечении |
| Условная проекция H2 на H при наклоне F на 20° | 16,5 × cos(20°) ≈ 15,51 | Для тонкой средней линии; реальный габарит считать по внешним поверхностям |
| Остаток высоты вне ушка и этой проекции | 33,5 − 11,3 − 15,51 ≈ 6,69 | Суммарный промежуток с учётом базы/перехода, не отдельная длина шейки |
| Радиус R27 для хорды 70 | 70 > 54 | Для одной дуги невозможно; R27 не задавать |
| Дно углубления при стенке 3,2 и глубине 1,5 | 3,2 − 1,5 = 1,7 | Только в одном и том же сечении по нормали |

**Правило замыкания высоты:** H1 = 33,5 является ведущим габаритом. Проушины 11,3, фланец 16,5 и их толщины сохранять. В CAD измерять H1 между касательными опорными плоскостями крайних внешних точек; не суммировать длины средних линий. Положение перехода/его эффективную длину подстроить так, чтобы получился H1 = 33,5. Размер шейки 5,1 — справочный стартовый параметр из исходника: если он конфликтует с H1, подчинить его габариту и отразить полученное значение на чертеже.

Например, даже грубая цепь 11,3 + 2,5 + 5,1 × cos(20°) + 16,5 × cos(20°) даёт около 34,10, а не 33,5. Эта цепь упрощённая и может учитывать перекрытия дважды. Поэтому не утверждать, что все прежние размеры замыкаются без изменений: расхождение порядка 0,6 мм устранять положением сопряжений и зависимой длиной перехода, а не уменьшением подтверждённой высоты ушка.

На IMG_4394.jpeg макушка–низ фланца занимает приблизительно 756 пикселей; при привязке к 33,5 это около 22,6 пикселя/мм. Высота видимой проушины порядка 255–260 пикселей соответствует примерно 11,3–11,5 мм. Это грубая взаимная проверка масштаба, согласующаяся с замером 11,3, но не калибровка всех поверхностей детали.

## 11. Фотографии и их назначение

| Файл | Что использовать |
| --- | --- |
| IMG_4391.jpg | Базовый боковой ракурс без разметки: ориентация всех узлов |
| IMG_6558.JPG | Общий силуэт лопатки, ушки, сужение и углы лопатки |
| IMG_6559.JPG | Проушины, рожки, взаимное расположение площадки и фланца |
| IMG_6560.JPG | Тыльные рёбра, полости зуба, продольное углубление |
| IMG_6561.JPG | Второй тыльный вид и область повреждения |
| IMG_4393.jpeg | Вид со стороны зуба и края фланца; две полости и общий силуэт лопатки |
| IMG_4394.jpeg | Авторская разметка габарита 33,5 |
| IMG_4395.jpeg | Авторская разметка собственного размера фланца 16,5 |
| IMG_4396.jpeg | Участки для оценки двух тупых углов |
| IMG_4397.jpeg | Наиболее удобный тыльный вид контура фланца, длинного углубления и трёх рёбер |

Передавать все десять оригиналов вместе с ТЗ. Три размеченных боковых изображения показывают один и тот же исходный ракурс, поэтому не являются тремя независимыми измерениями. Фото перспективные; шаг сетки 5 мм заявлен в исходнике, а детали находятся над плоскостью бумаги. Мелкие надписи и круглые следы на тыльной поверхности не считать отверстиями или обязательной функциональной геометрией без подтверждения; в базовой модели опустить.

## 12. Полный набор рабочих допущений для первой модели

Эти решения позволяют закончить модель без нового цикла вопросов. Статус **Д** означает осознанный выбор конструктора для реконструкции, а не якобы измеренную по фотографии величину. Все такие параметры оставить редактируемыми. При конфликте приоритет у размеров **У** и общей топологии по фото.

### 12.1. Приближённый контур фланца

В локальной плоскости фланца: X поперёк ширины, V от прямой, соединяющей крайние кончики крылышек, к центральной выпуклой кромке. Начало — середина этой прямой; симметрия относительно X = 0. В данном описании «верх/низ» не привязаны к повороту фотографии.

Начальные точки выпуклой кромки, полученные приближённой нормировкой силуэта IMG_4397.jpeg на ширину 70 и высоту 16,5:

| X | V | Статус |
| ---: | ---: | --- |
| 0 | 16,5 | У для максимального размера; привязка к локальному контуру — Д |
| ±9 | 16,2 | О/Д |
| ±18 | 13,8 | О/Д |
| ±26 | 8,5 | О/Д |
| ±35 | 0 | И для ширины 70; локальная база — Д |

Провести симметричный плавный сплайн без перегибов и волн; в центре касательная параллельна X. Таблица задаёт стартовую форму, не точный обмер. Проверить контур визуально по IMG_4397.jpeg; промежуточные точки можно корректировать, сохраняя габариты. Противоположная кромка крылышек в первой модели — общая прямая V = 0 с плавными переходами к центральной шейке. Значение 36 из исходника использовать как стартовую ширину центрального сопряжения у этой кромки, а не длину несуществующей «малой стороны» идеальной трапеции. Шейку шириной 34 соединить с этим участком плавно.

Толщина 3,2 — по нормали к локальной плоскости. Базовый вариант — без отдельно назначенного пространственного изгиба. Если при наложении всех видов понадобится плавный изгиб, вводить его отдельным параметром после согласования, не менять радиус контура вместо изгиба.

### 12.2. Остальные недоопределённые элементы

| Элемент | Решение для первой CAD-модели | Статус и ограничение |
| --- | --- | --- |
| Вершина ушка | Симметричная округлая вершина; стартовая дуга R4,15 с центром в отверстии, касательный плавный переход к основанию длиной 10,5; высота 11,3 | Д; радиус здесь выбран для построения, а не выведен как факт |
| Центр отверстия вдоль основания ушка | По середине основания длиной 10,5: 5,25 от его торца | Д; положение основания на площадке принять заподлицо с её торцами |
| Центр отверстия по высоте | 7,15 над A | Р из исходных 2,9 и Ø2,5 и уточнённых 11,3 |
| Кромки отверстий | Обычное сквозное Ø2,5 без цековки; небольшое притупление 0,2 × 45° | Д для притупления; не копировать повреждённый ободок |
| Корень проушин | Стартовая галтель R0,5 | Д; не уменьшать рабочий зазор 21,8 на участке посадки ответной детали |
| Рожки | Межцентровое 18, вылет 2, ширина 2,2, толщина 2,5; скругление открытых кромок R0,4 | И/О для размеров, Д для скругления |
| Шейка | Ширины 32,68 → 34, толщина 3, угол β = 110°; начальная длина 5,1, итоговая зависима от H1 | И/О/Д; итоговую длину обязательно вывести на чертёж |
| Три ребра | Среднее по B, два крайних непосредственно у боковых краёв перехода; толщина 2, профиль около 4,5 × 4,5 с учётом реального угла, галтели R0,5 | О для размеров, Д для сопряжений; рёбра не делать отдельными несвязанными телами |
| Продольное углубление | 48 × 2,5, глубина 1,5; симметрично по X; закрытые полукруглые концы R1,25; центр по V около 5,0 от прямой кончиков крылышек | О для размеров, Д для точной формы и позиции; видимое широкое обрамление не включать автоматически в ширину 2,5 |
| Лопатка | Длина 30, ширины 52 у корня и 40 у конца; R10 двух углов | У/И; для построения 40 трактовать как ширину трапециевидной заготовки до скруглений |
| Толщина лопатки | 6 у корня → 3 у свободного края, плавное уменьшение; скругление торца R1,5 по толщине | И для 6; Д для 3 и R1,5; фото не даёт точного профиля |
| Внутренняя выемка лопатки | В первой модели отдельную глубокую выемку не добавлять; удобство края обеспечить плавным профилем и торцевым скруглением | Д; исходная фраза о выемке недостаточна, скрытую поверхность по фото не восстановить |
| Мелкие наружные кромки фланца | Стартовые скругления R0,5; кончики крылышек R1 в контуре | Д; сохранять конечный габарит 70 после скругления |
| Микрофактура, маркировка, круглые технологические следы | Опустить | Д; не влияют на базовую геометрию зацепления |

### 12.3. Рабочая реконструкция зуба

По ширине зуб симметричен относительно B; общая ширина 17,5. Основное направление прямое, параллельно P; выступ направлен с тыльной стороны фланца. В центральном боковом сечении исходить из следующего:

1. Установить корень рядом с нижней/выпуклой наружной кромкой фланца, как на IMG_4391.jpg. Для первой модели оставить между наружной кромкой фланца и ближайшей границей корня зуба отступ 0,5 вдоль F (**Д**, по фото точный отступ не определяется).
2. От согласованной тыльной поверхности корня отложить вылет 10 вдоль направления зуба. Максимальная толщина по нормали к P — 5,2, толщина свободного конца — 2,0. Сохранить одну продольную грань прямой и параллельной P, противоположную выполнить скосом. Это простая стартовая реконструкция внешней оболочки, а не подтверждение утраченной заводской формы.
3. Конкретную удерживающую ступеньку не назначать произвольной величиной и не изображать как доказанный элемент. В CAD предусмотреть параметрическую возможность добавить/переместить эту грань после проверки по ответной части. До проверки рабочая поверхность остаётся реконструкцией простого клинового выступа.
4. Для полной внешней модели зуба принять сплошное тело (**Д**, вариант реконструкции). В оригинале видны две полости; их размеры и назначение неизвестны. Сплошной вариант не считать идентичным оригиналу по гибкости и прочности. Если требуется точная копия внутреннего строения, понадобятся отдельные замеры полостей; не выдумывать их размеры по теням.
5. Принять корневую галтель R1,0 как стартовое конструктивное решение, только вне зоны контакта. Внешние кромки конца притупить R0,3 (**Д**). Не изменять основное направление зуба ради скоса или галтели.

Для позиционной проверки по боковому снимку: центр видимого отверстия примерно (775,510), область корня зуба примерно (650,1100) в IMG_4394.jpeg. При условном масштабе 756 / 33,5 ≈ 22,6 пикселя/мм корень расположен приблизительно на **26 мм ниже C по H** и на **5–6 мм в сторону лопатки в горизонтальной проекции снимка**. Это оценка порядка положения с неопределённостью в несколько миллиметров из-за перспективы, толщины и выбора границы. Она **не задаёт положение удерживающей грани**. Использовать только как проверку, что зуб находится на нужной стороне и уровне. Не добавлять эти координаты как жёсткие ограничения поверх уже заданных размеров фланца.

## 13. Последовательность моделирования и выдача результата

1. Создать параметрический боковой эскиз и плоскость симметрии B. Главные параметры: H1 = 33,5, H2 = 16,5, H3 = 11,3, L1 = 30; α = 110°, β = 110°, γ = 0°, δ = 0°. Последние четыре — оценки/допущения.
2. Построить проушины и площадку с рожками. Сохранить Ø2,5, толщину 3 и внутренний зазор 21,8 как отдельные параметры.
3. Построить фланец по симметричному контуру раздела 12, задать толщину и наклон. Расположить его так, чтобы внешний габарит вдоль H был ровно 33,5. Соединить с площадкой шейкой, подчиняя её эффективную длину этому габариту.
4. Построить лопатку от ступеньки S, затем зуб с тыльной стороны. Проверить, что зуб почти прямой и параллелен P, а не загнут к фланцу.
5. Добавить рёбра, углубление и скругления. Все элементы объединить в одно корректное твёрдое тело; повреждения не воспроизводить.
6. Сопоставить боковой, лицевой и тыльный виды модели с фотографиями. Не исправлять перспективное несовпадение ценой изменения подтверждённых размеров.
7. Выдать исходный параметрический CAD-файл, STEP и чертёж с боковым сечением, видом фланца, профилем проушины и таблицей принятых допущений. Для печати добавить STL/3MF в миллиметрах. На чертеже показать итоговую зависимую длину шейки и положение зуба относительно C.

### Критерии приёмки первой геометрической модели

- Сохранены четыре уточнённых размера 33,5 / 16,5 / 11,3 / 30 с определениями из этого ТЗ.
- Две проушины и отверстия соосны; зазор и толщина не перепутаны с межцентровым расстоянием.
- Фланец шириной 70 имеет плавный симметричный фигурный контур; неподтверждённый R27 не применён ко всему размаху.
- Оба тупых угла построены на правильной стороне; зуб не имеет сильного загиба.
- Все оценки и допущения явно помечены в параметрах; нет случайных щелей, самопересечений и отдельно висящих тел.

### Что остаётся проверить перед изготовлением окончательной рабочей детали

Документ позволяет закончить CAD-реконструкцию без новых фотографий. Однако **функциональная посадка ещё не доказана**. Проверить на ответной детали или прототипе: Ø отверстий и посадку оси, положение удерживающей грани зуба, свободный ход ручки, отсутствие столкновения фланца/рожков и требуемое усилие защёлкивания. Материал, производственные допуски и компенсации печати выбрать отдельно. Если доступен только один дополнительный контроль, наиболее полезна примерка рабочего зуба к ответному зацепу: именно его повреждённый профиль нельзя достоверно восстановить из имеющихся фото.
