etonealbert/frontier-navara-alaskan-latch/ENGINEERING_RULES.md

# ENGINEERING_RULES.md — как проектировать защёлку, а не просто визуальную оболочку

## Источник истины

Оба исходника `input/` обязательны. ТЗ имеет статусы размеров **У** (владелец), **И** (из старого описания), **О** (оценка), **Д** (допущение), **Р** (расчёт), **?** (неизвестно). Эти метки перенести в читаемую таблицу параметров/отчёт; не подменять О/Д измеренными размерами.

## Система координат и конструктивная логика

- X — вдоль общей оси двух отверстий C; B = X=0 — симметрия.
- Z — нормаль к площадке A в сторону верха проушин; H для V01 совпадает с Z.
- Y — дополняет правую тройку осей.
- P — плоскость прямой части лопатки, **отдельная** от A (стартовое δ=0°). Фланец имеет направление F примерно на 20° к H, правильный знак уточнять по боковому фото.
- S — точка/линия ступеньки, начало длины лопатки. Запиши, какую кромку считаешь S.
- Углы α/β из раздела 10 измеряются между конкретно описанными лучами; не заменять градусы на самодополняющие углы без фиксации знака/лучей.

## Геометрия по ТЗ

**Проушины:** 2 шт.; Ø3,1 (исправленный замер владельца 13.11.2026; Ø2,5 в ТЗ ошибочен); толщины по X 3,0; внутренний зазор 21,8; наружный размах 27,8; X центров ±12,4; центры отверстий на Z = 11,3 − (2,9 + Ø/2) = 6,85 от A (расчёт при условных измерениях; при прежнем Ø2,5 было 7,15); высота макушки Z=11,3. Внешняя дуга с центром в отверстии R = 2,9 + Ø/2 = 4,45 (в ТЗ R4,15 при Ø2,5) — только Д по разд.12. Помни о фасках и необходимости не съесть рабочий зазор галтелями.

**Площадка/рожки:** ширина 30,8→32,68; длина 10,5; толщина 2,5; два рожка с центрами по X ±9, вылет 2 и ширина ~2,2. Построить непрерывное сопряжение с проушинами/шейкой.

**Шейка:** толщина 3; ширина 32,68→34; три ребра, не висящие отдельно. Старт длины 5,1, но итоговая длина **подчинена габариту H1**; документируй фактическую длину и правило замыкания.

**Фланец:** ширина 70, толщина 3,2, высота 16,5 вдоль F. Не назначай R27 на всю кромку! Используй симметричные опорные точки из разд.12.1, плавную кривую. В первой модели не выдумывай дополнительный пространственный изгиб. Длинный тыльный паз ~48×2,5×1,5 — допущение, закрытые концы; не режь фланец насквозь.

**Лопатка:** длина 30 от S вдоль P; ширина в основании 52, на свободном конце 40 (до скруглений), крайние углы R10; толщина 6→3 плавно по длине. Не копируй микрофактуру как обязательную деталь.

**Зуб:** ширина 17,5, длина 10, толщина 5,2 у корня→2 у конца; выступ с тыла; основная продольная грань почти строго параллельна P. Две видимые на исходнике полости НЕ подтверждены для параметрического воспроизведения: V01 может быть сплошным вариантом. Не выдумывай точное положение, угол/высоту рабочей удерживающей ступеньки; конструкция V01 должна позволять задавать её позже. R1 у корня и R0,3 у конца — допущения, не вмешиваться в контактную поверхность.

## Практика build123d

- Используй стабильный build123d с PyPI; `export_step(part, path)` и `export_stl(part, path)` — подтверждённые в официальном репозитории методы. Пример кода смотри в README `gumyr/build123d` и документации. Не передавай в экспорт `None` или `Compound` из несвязанных тел и не называй его полнотелой деталью.
- Разделяй **значения параметров**, **конструкцию геометрии**, **валидатор** и **экспорт**. Скрипт должен запускаться без ручных кликов и пересобирать обе выдачи одной командой.
- Для отдельных сложных операций используй устойчивую декомпозицию и обоснованные булевы пересечения. Недопустимо скрывать ошибки скругления пустым `except` и молча выдавать деталь без существенных сопряжений.
- Убедись, что отверстия являются настоящими сквозными в правильной ориентации. Измеряй внутренний просвет между плоскостями, а не расстояние между осями.
- Нельзя точно восстановить размер по ракурсной клетчатой бумаге. Фотографии помогают с топологией и направлением, а не заменяют размеры.

## Выявление инженерных рисков

Это **автомобильный пластиковый подвижный фиксатор**. Важны направление сил, корневой радиус, износостойкость, повторная циклическая нагрузка, нагрев салона и анизотропия FDM-печати. Не обещай прочность без расчёта, выбора материала и испытаний. Без ответного зацепа функциональная пригодность зуба не установлена. Задача V01 — проверяемая геометрия и прототип для примерки, не сертифицированная замена.
