etonealbert/frontier-navara-alaskan-latch/START_AGENT.md

# START_AGENT.md — задание, запускаемое без новых уточнений

## Цель

Из двух файлов в `input/` создать **первую полную параметрическую 3D-реконструкцию ручки-защёлки крышки центрального подлокотника автомобиля** на **gumyr/build123d**. Нужны **реальные, читаемые в CAD/слайсере** STL + STEP для передачи владельцу и печатнику, а также редактируемый Python-исходник.

**Исходные файлы (читать оба):**

1. `input/cad-latch-spec(1).md` — детальное ТЗ, редакция 2 (не сокращённая заметка).
2. `input/cad-photo-atlas(1).pdf` — 12 страниц, 10 фотографий исходной детали.

Не переписывай исходное ТЗ и не заменяй его общими советами из интернета. Если документация API нужна, опирайся на https://github.com/gumyr/build123d и https://build123d.readthedocs.io/en/latest/.

## Задание по шагам

**A. Подготовь окружение:** проверь `py -3.12`, `python`, `winget`; установи Python 3.12 при необходимости с согласия владельца, создай `.venv`, установи **stable** `build123d` с PyPI, проверь `import build123d`. FreeCAD — опциональный просмотрщик, не обязательный для генерации. Не клонируй development branch из GitHub без технической причины. Сохрани версии среды.

**B. Разбери источники:** прочитай ТЗ полностью; отрендерь страницы PDF для сравнения всех ракурсов; составь карту: часть → размеры/происхождение → расположение → функция → риск/неизвестное. Используй базы A/B/C/P/S и направления H/F из ТЗ; сохрани правильные определения размеров.

**C. Реализуй build123d CAD:** параметризуй компоненты и их базовые системы координат, соблюдая топологию фотографий. Сначала главные твёрдые тела и размерные цепи, затем отверстия, рёбра, паз, скругления. Выполняй перестроение и тестирование после каждой логической стадии. Связи должны быть не случайным подбором координат, а расчётными трансформациями от параметров. Старайся получить **единое твёрдое тело без пересечений, щелей и висящих деталей**.

**D. Зуб:** он расположен с тыльной стороны фланца, почти прямой и **параллелен основной плоскости лопатки**, НЕ выраженно изогнут. Для V01 применяй наружную оболочку по разделу 12.3 ТЗ и сохраняй возможность отдельно изменить параметры удерживающей грани после примерки. Повреждения и две неподтверждённые внутренние полости не «восстанавливай» как доказанную геометрию.

**E. Проверки и выдача:** следуй `ACCEPTANCE_CHECKLIST.md`. Обязательно получи `output/armrest_latch_v03.step` и `output/armrest_latch_v03.stl`, сравни их с исходными параметрами, проверь геометрическую валидность и размеры, сохрани исходники и отчёты. Если доступна визуализация, выдай изометрию, боковой и тыльный виды в `output/`.

## Габариты, которые нельзя перепутать

- **33,5 мм** — H1: **между макушкой проушины и нижней кромкой фланца** вдоль H; нажимная лопатка **не входит**.
- **16,5 мм** — H2: **высота самого фланца вдоль наклонного направления F**, не толщина и не вертикальная проекция.
- **11,3 мм** — H3: от базовой площадки A до вершины проушины.
- **30,0 мм** — L1: от ступеньки S до свободного торца лопатки вдоль P.
- Оба ~110° — углы специфических лучей раздела 10 ТЗ, не произвольные 110° между произвольно выбранными нормалями.
- Зуб: 17,5 мм ширина, предварительный вылет 10,0 мм, корень до 5,2 мм, конец около 2,0 мм; **угол основного участка к лопатке 0°** как допущение.

## Условие завершения

Не заканчивай одним отчётом или кодом. Положи действительные файлы STEP и STL в `output/`, положи работающий код в `src/` и отчёты в `reports/`. Если этого достичь не удалось, явно отметь, что задача **не завершена**, причины и промежуточные реальные файлы. Заявления о проверке должны соответствовать реальным запускам и измерениям.
