etonealbert/frontier-navara-alaskan-latch/output/armrest_latch_v03_back.png

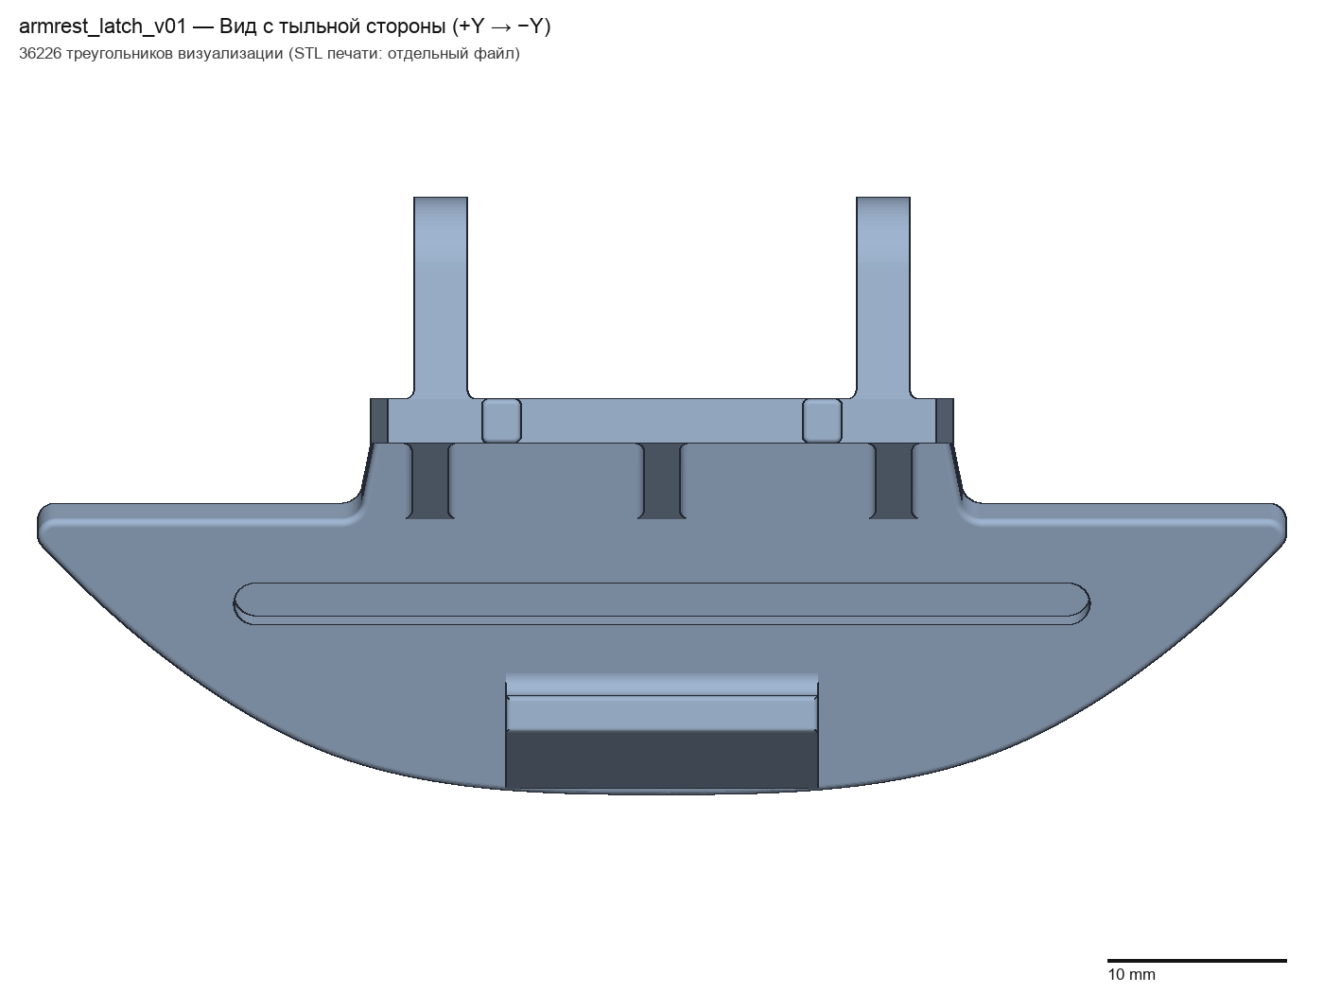
output/armrest_latch_v03_back.png
