etonealbert/frontier-navara-alaskan-latch/output/armrest_latch_v03_drawing.png

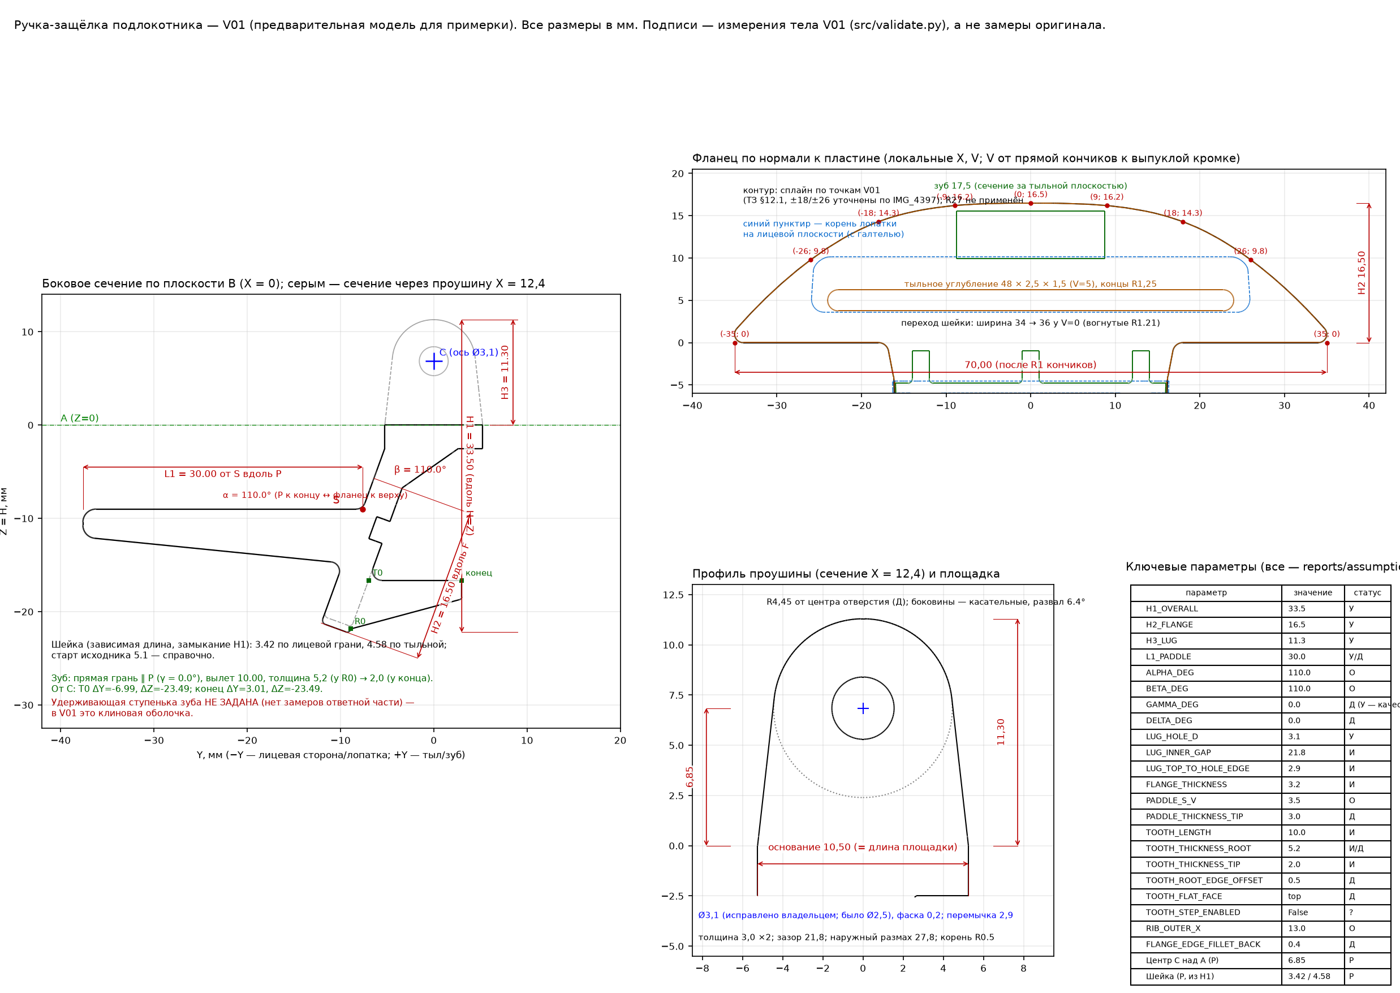
output/armrest_latch_v03_drawing.png
