etonealbert/frontier-navara-alaskan-latch/output/armrest_latch_v03_front.png

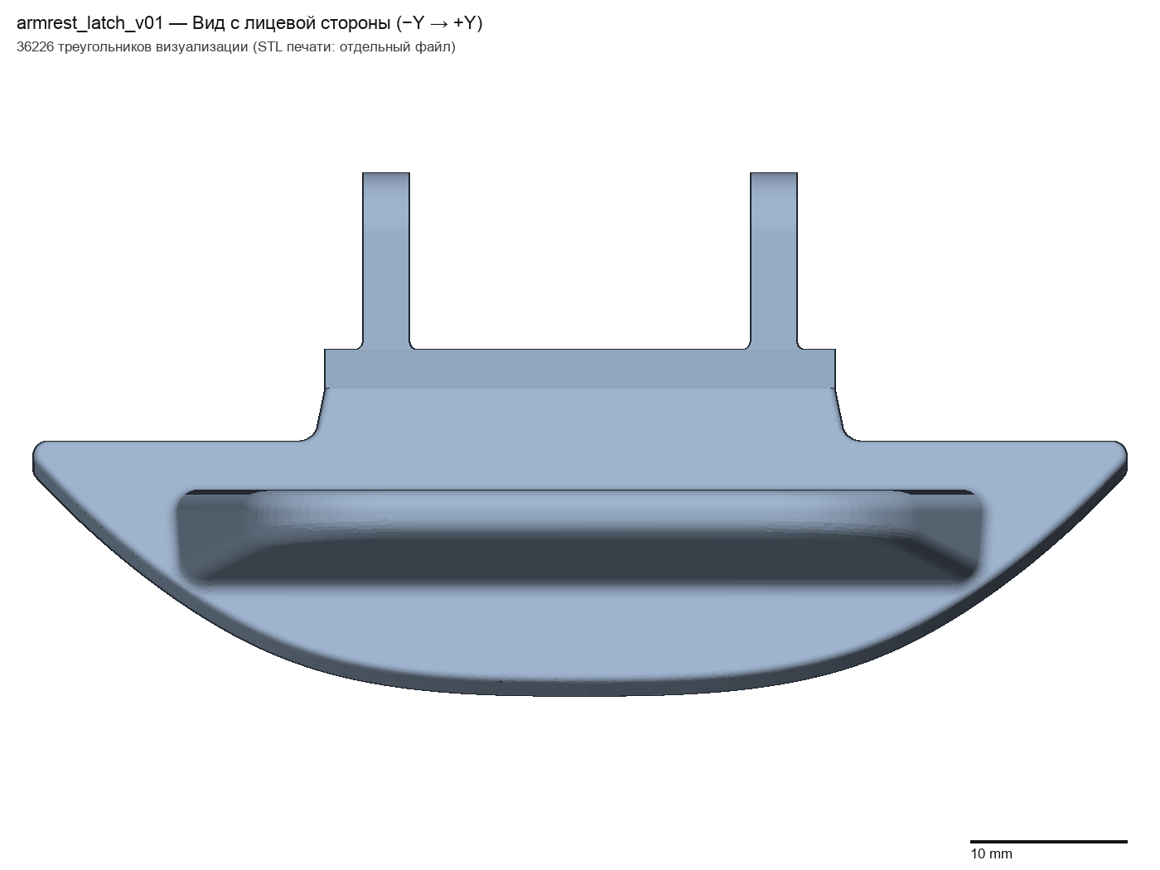
output/armrest_latch_v03_front.png
