etonealbert/frontier-navara-alaskan-latch/output/armrest_latch_v03_top.png

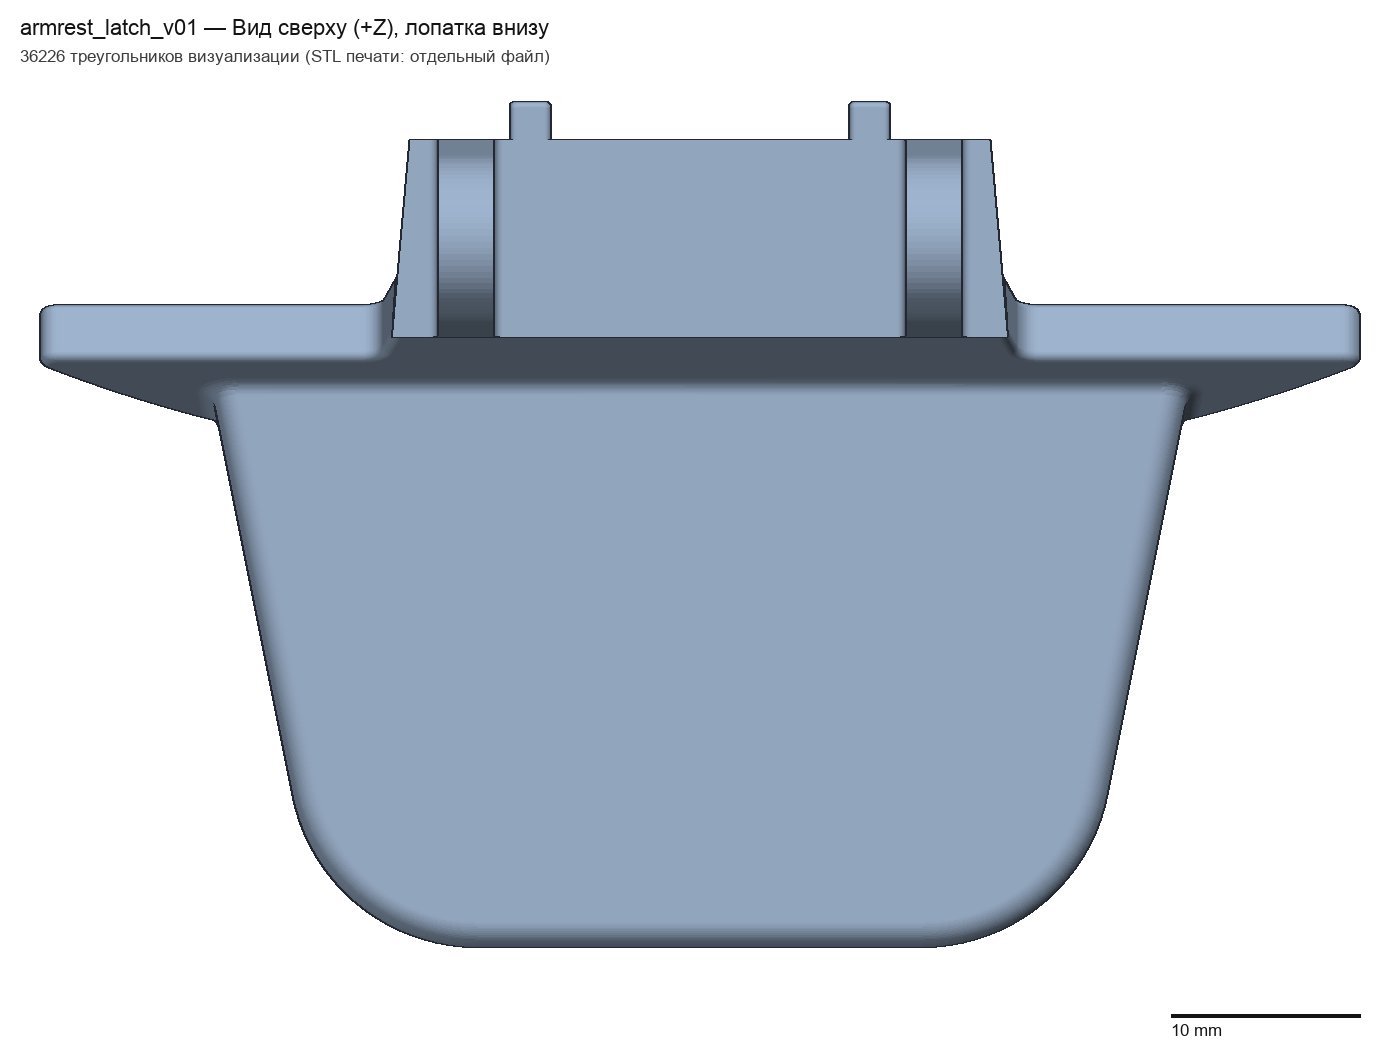
output/armrest_latch_v03_top.png
