etonealbert/frontier-navara-alaskan-latch/reports/figures/compare_front_IMG_6558.png

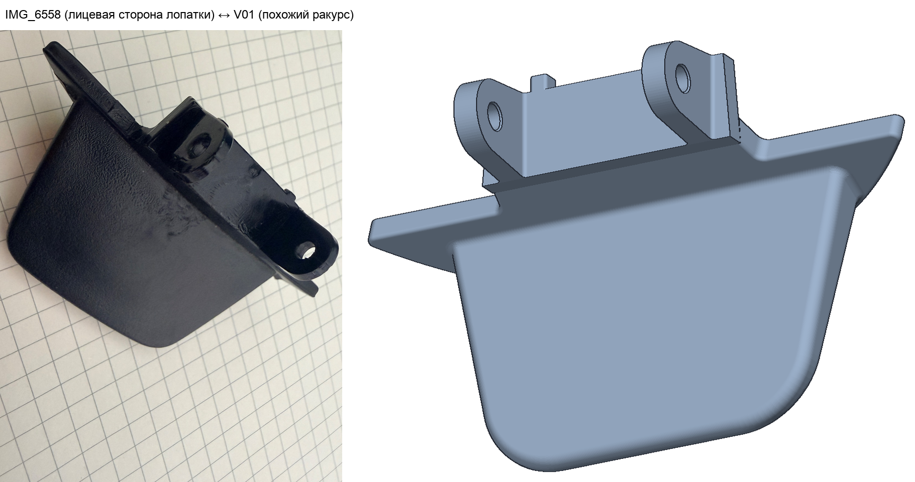
reports/figures/compare_front_IMG_6558.png
