etonealbert/frontier-navara-alaskan-latch/reports/figures/compare_rear_IMG_4397.png

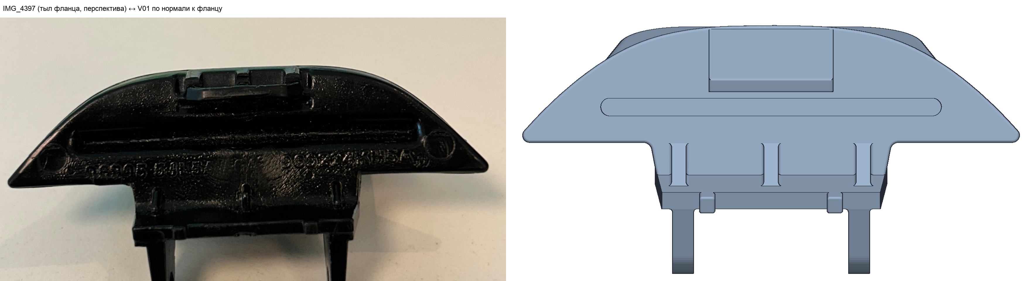
reports/figures/compare_rear_IMG_4397.png
