etonealbert/frontier-navara-alaskan-latch/reports/figures/compare_side_overlay_IMG_4396.png

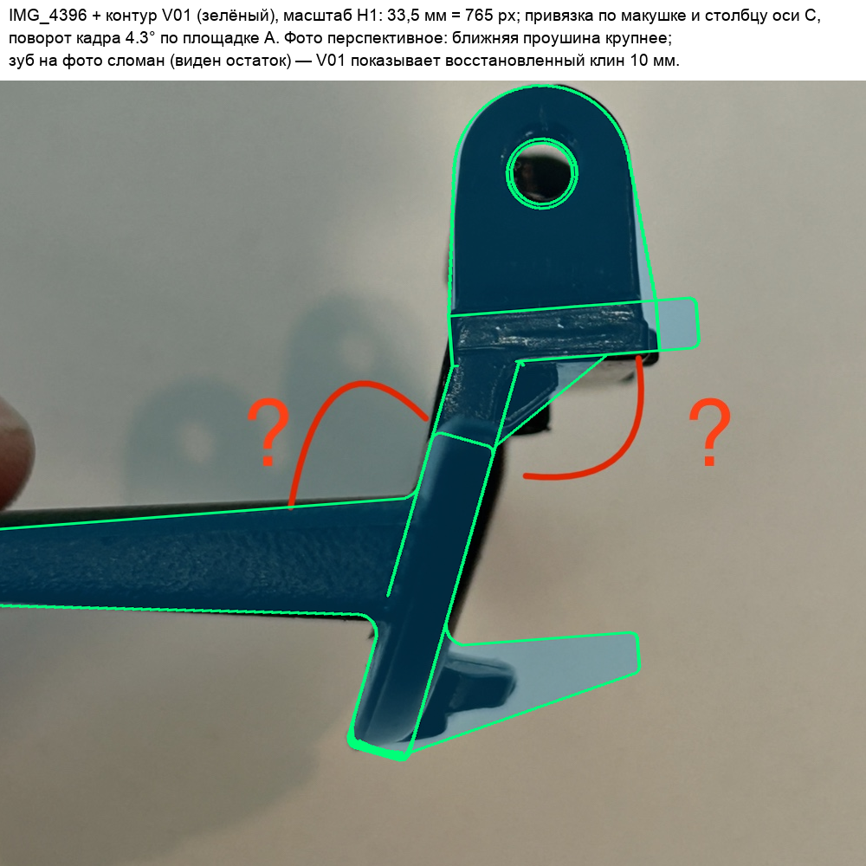
reports/figures/compare_side_overlay_IMG_4396.png
