etonealbert/frontier-navara-alaskan-latch/reports/figures/compare_tooth_side_IMG_4393.png

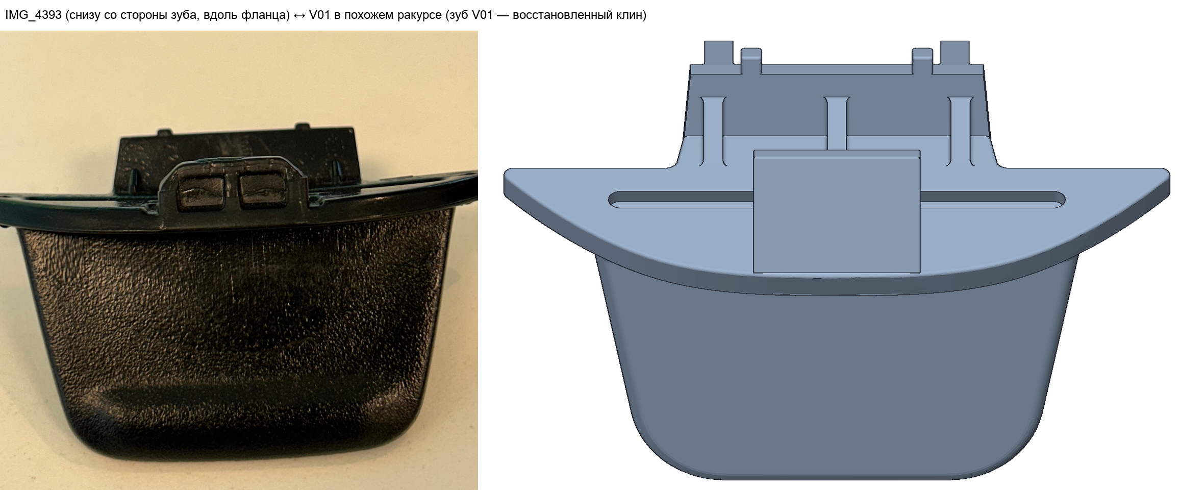
reports/figures/compare_tooth_side_IMG_4393.png
