etonealbert/frontier-navara-alaskan-latch/output/armrest_latch_v03.step

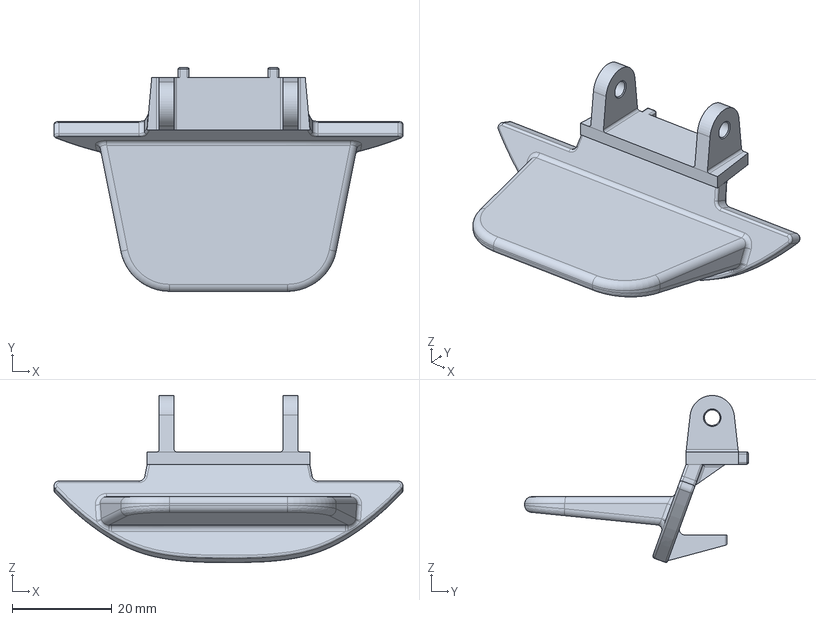
[picture p23: CAD file, 2026-11-14]
output/armrest_latch_v03.step
70.0 x 44.9 x 33.5 mm
