etonealbert/frontier-navara-alaskan-latch/(list of files, cad)

Other CAD files:
output/armrest_latch_v03.stl
