etonealbert/frontier-navara-alaskan-latch/reports/print_handoff.md

# Передача печатнику: ручка-защёлка V01

> **V01 — прототип для примерки, не проверенная по посадке и прочности деталь.** Рабочая (удерживающая) грань зуба
> не восстановлена по замерам; деталь нужна, чтобы примерить её к крышке и ответному зацепу и снять недостающие размеры.

> **Редакция 13.11.2026: отверстия проушин Ø3,1** (исправленный замер владельца; прежний Ø2,5 был неверен).
> Файлы STL/STEP, выданные до этой даты, **не печатать**. Проверка в слайсере: отверстия Ø3,1, ось на 6,85 мм
> над площадкой с проушинами.

## Что отправлять

| Файл | Назначение |
|---|---|
| [`output/armrest_latch_v03.stl`](../output/armrest_latch_v03.stl) | Сетка для слайсера. **Единицы — миллиметры** (STL единиц не хранит). Замкнута, одно тело, 87 364 треугольника, допуск триангуляции 0,01 мм |
| [`output/armrest_latch_v03.step`](../output/armrest_latch_v03.step) | Твердотельная модель (STEP AP214, мм) — если нужно перетриангулировать или доработать в CAD |
| [`output/armrest_latch_v03_drawing.png`](../output/armrest_latch_v03_drawing.png) / `.svg` | Схема с основными размерами и положением зуба относительно оси |
| `output/armrest_latch_v03_{iso,iso_rear,side,rear,front,top,back}.png` | Виды для ориентации |

Оба файла получены из одного и того же твёрдого тела (`src/model.py`); совпадение объёма и габаритов проверено
(`reports/validation.md`, разделы STEP/STL).

**Контроль масштаба в слайсере:** габариты должны быть **70,0 × 44,9 × 33,5 мм** (X × Y × Z). Если слайсер показывает
≈2,76 × 1,77 × 1,32 — он принял дюймы; переключить единицы на мм, **не масштабировать** вручную.

Объём тела 11,0 см³ → масса при 100 % заполнения: PLA ≈ 13,6 г, PETG ≈ 14,0 г, ASA ≈ 11,8 г, PA12 ≈ 11,1 г.

## Ориентация (на выбор печатника, G-code не прилагается)

Исходная система координат файла: Z вверх — макушки проушин; лопатка уходит к −Y, зуб — к +Y. Плоской опорной грани
у детали нет — при любой ориентации нужны поддержки.

| Вариант | Плюсы | Минусы |
|---|---|---|
| **A. «На боку»**: ось отверстий X вертикально (повернуть на 90° вокруг Y) | Отверстия Ø3,1 печатаются вертикально и круглыми; профили зуба, проушин, фланца и лопатки лежат в плоскости слоя — изгиб зуба и проушин вдоль нитей, а не поперёк слоёв | Высота ≈70 мм, малая опорная площадь на кончике крылышка — нужны древовидные поддержки и кайма |
| B. Как в модели (Z вверх) | Зуб и лопатка горизонтальны (изгиб зуба вдоль нитей) | Корни проушин и фланец нагружаются поперёк слоёв; отверстия горизонтальные (возможен провис свода); много поддержек под лопаткой и зубом |
| C. SLS/MJF (PA12/PA11) | Почти изотропная прочность, поддержки не нужны, хорошая точность мелких элементов | Дороже и дольше |

Для **функционального** прототипа предпочтительны SLS/MJF или FDM в варианте A.

## Материал и режимы (рекомендации, не гарантия)

- **PLA — только для примерки на столе**: размягчается около 55–60 °C, в салоне летом заметно жарче.
- Для проверки в автомобиле: ASA, PETG, PA (нейлон), PC или PA12 (SLS/MJF). Теплостойкость и прочность **не
  подтверждены** — нужны испытания.
- Зуб и проушины — сплошные: заполнение 100 % (или ≥ 5 периметров), слой 0,12–0,2 мм.
- Мелочи ниже разрешения FDM (сопло 0,4): фаски отверстий 0,2, скругления R0,3–R0,5, поясок 0,2 на торце лопатки —
  их потеря допустима.
- **Отверстия Ø3,1** (номинал по исправленному замеру владельца) в модели без компенсации усадки. FDM обычно даёт
  отверстия на 0,1–0,2 мм меньше: развернуть сверлом Ø3,1 (или по фактическому диаметру оси с нужным зазором) либо
  изменить `LUG_HOLE_D` в `src/params.py` и пересобрать (`src/run_all.py`). Не масштабировать всю модель.

## Что проверить при примерке (и записать для V02)

1. Ось: проходит через оба отверстия Ø3,1, соосность, свободное вращение без заеданий, люфт; фактический Ø оси.
   Высота оси над площадкой (6,85 по расчёту из перемычки 2,9) — сравнить с оригиналом.
2. Зазор между проушинами 21,8 относительно бобышки крышки, люфт вдоль оси.
3. Рожки: упираются ли в ответные упоры на концах хода.
4. Положение ручки в проёме: зазоры фланца и лопатки, положение свободного конца лопатки.
5. **Зуб**: заходит ли за ответный зацеп; величина перекрытия; где должна быть удерживающая грань относительно оси C
   (ΔY, ΔZ); работает ли скос как заходная фаска; выходит ли зуб из зацепления при нажатии на лопатку; ход лопатки.
6. Усилие защёлкивания и открывания (возврат пружиной, если она есть).
7. Нужные изменения внести параметрами: `TOOTH_LENGTH`, `TOOTH_THICKNESS_*`, `TOOTH_STEP_*`, `GAMMA_DEG`,
   `PADDLE_S_V`, `H1_OVERALL` (точка замера), `LUG_*`; затем `src/run_all.py`.

## Риски, которые печатник и владелец должны учитывать

- **Удерживающая грань зуба не задана** (нет замеров ответной части): V01 может не держать крышку или не выходить из
  зацепления — это ожидаемо для примерочного прототипа.
- Зуб сплошной, у оригинала две полости — жёсткость и усилие защёлкивания отличаются.
- Оригинальный зуб сломался; корневая галтель R1 снижает концентрацию напряжений, но прочность и усталостная стойкость
  **не рассчитывались и не испытывались**.
- Длина шейки (3,42 мм) выведена из H1 при допущении, что H1 измерен до тыльной нижней кромки фланца; при замере до
  лицевой кромки фланец сместится примерно на 1 мм.
- Высота оси C (6,85 над площадкой) — расчёт из перемычки 2,9 и Ø3,1, а не прямой замер; если на оригинале ось на
  7,15, то в V01 зуб и фланец стоят относительно оси на 0,3 мм выше, чем нужно (исправляется параметром
  `LUG_HOLE_CENTER_Z_FIXED`).
- Углы 110° (α, β) — оценка по фото ±5°; положение S и контур фланца — оценки.
- Анизотропия FDM: слабые места — корни проушин и корень зуба при печати поперёк нагрузки.
