etonealbert/frontier-navara-alaskan-latch/reports/validation.md

# Отчёт о проверке V01 — ручка-защёлка подлокотника

> Файл сгенерирован `src/validate.py` 2026-11-13 11:00:57. Все числа ниже — результаты реальных
> измерений тела, перестроенного из `src/`, и обратного импорта выданных файлов. Посадка и работа зуба
> **не проверены** (нет ответной детали и примерки).

**Итог автоматических проверок:** INFO: 7, NOT CONFIRMED: 1, PASS: 107. Провалов нет.

Среда: Python 3.13.7, build123d 0.13.0, OCP 8.0.1.1.0, trimesh 4.7.0, manifold3d 3.5.4, macOS-26.7.1-arm64-arm-64bit-Mach-O. Время проверки 73.6 с.

Объём тела: **11008.37 мм³**. Габариты (мм): X -35.000…35.000, Y -37.617…7.250, Z -22.200…11.300.

Базы: X — ось C, Z — нормаль к A (H = Z), +Y — тыльная сторона; начало — на A под осью C в плоскости B.

## Чек-лист приёмки (ACCEPTANCE_CHECKLIST.md)

`[x]` — пункт подтверждён перечисленными проверками этого отчёта (PASS; INFO — значение записано; NOT CONFIRMED — честно помечено неподтверждённым) или выполненным ручным осмотром.

- [x] Прочитан полный ТЗ; использованы §12 (допущения) и §13 (требования). _вручную — «Ручные проверки → Источники»; итог в src/params.py и assumptions.md_
- [x] Просмотрен PDF с изображениями, не только текст; сопоставлены боковой и задний виды, разметка H1/H2 и углы. _вручную — все 12 страниц отрендерены, 10 фото извлечены; reports/figures/compare_*.png_
- [x] Статусы У/И/О/Д/Р/? сохранены в параметрах и таблице допущений. _поле status каждого параметра в src/params.py; reports/parameters.md; reports/assumptions.md_
- [x] Полная модель: две проушины, отверстия, рожки, шейка, 3 ребра, фланец с крылышками, лопатка, тыльное углубление, зуб. _Проушины: «Сечение по X над отверстием: два интервала» — PASS; Проушины: «Отверстия сквозные по оси C» — PASS; Рожки: «Количество рожков» — PASS; Шейка: «Ширина шейки у площадки» — PASS; Рёбра: «Количество рёбер (раздельные, в центре треугольника профиля)» — PASS; Фланец: «Полная ширина 70 (после скругления кончиков R1)» — PASS; Углубление: «Длина 48 с закрытыми концами» — PASS; Лопатка: «Толщина при u=15 от S (6 → 3 линейно)» — PASS; Зуб: «Ширина 17,5, симметрично B» — PASS_
- [x] H1 = 33,5 от макушки ушка до нижнего края фланца вдоль H, без лопатки. _Главные размеры: «H1 = 33,5: макушка проушины → нижняя кромка фланца вдоль H (=Z)» — PASS; Главные размеры: «Верхняя точка H1 — макушка проушины» — PASS; Главные размеры: «Нижняя точка H1 — фланец, не лопатка и не зуб» — PASS_
- [x] H2 = 16,5 вдоль F фланца, а не по общему габариту. _Главные размеры: «H2 = 16,5: собственная высота фланца вдоль F» — PASS_
- [x] H3 = 11,3 от A до вершины ушка. _Главные размеры: «H3 = 11,3: от A до макушки проушины по нормали к A» — PASS_
- [x] L1 = 30,0 от S до края лопатки вдоль P. _Главные размеры: «L1 = 30,0: от S до крайней точки свободного торца вдоль P» — PASS_
- [x] Ø у обеих проушин (по исправленному замеру владельца 3,1; в ТЗ — Ø2,5); соосность; две толщины 3,0; внутренний зазор 21,8. _Проушины: «Диаметр отверстий Ø3,1 (грани-цилиндры, обе проушины)» — PASS; Проушины: «Диаметр отверстий Ø3,1 (лучи в средних плоскостях проушин)» — PASS; Проушины: «Соосность отверстий (отклонение осей от C)» — PASS; Проушины: «Толщина проушины (−X) 3,0» — PASS; Проушины: «Толщина проушины (+X) 3,0» — PASS; Проушины: «Чистый зазор между внутренними гранями 21,8» — PASS_
- [x] Ширина фланца 70; непрерывная симметричная кромка без ложного общего R27. _Фланец: «Полная ширина 70 (после скругления кончиков R1)» — PASS; Фланец: «Выпуклая кромка без перегибов и волн» — PASS; Фланец: «Симметрия контура относительно B» — PASS; Фланец: «Нет общего R27: радиус кривизны у вершины» — PASS_
- [x] Оба угла 110° с правильным знаком и лучами (§10). _Углы: «α лопатка–фланец ≈110°» — PASS; Углы: «β площадка–шейка ≈110°» — PASS; Углы: «Наклон F к H» — PASS; сторона наклона дополнительно сверена наложением на IMG_4396_
- [x] Зуб не загнут (основное направление ∥ P); рабочая ступенька не выдана за подтверждённый факт. _Углы: «γ зуб–P = 0° (зуб не загнут)» — PASS; Зуб: «Удерживающая ступенька» — NOT CONFIRMED; ступенька — статус NOT CONFIRMED_
- [x] Шейка замыкает H1 (итоговая длина записана); все рёбра объединены с деталью. _Шейка: «Итоговая длина шейки по лицевой грани (Р, из H1)» — INFO; Рёбра: «Рёбра объединены с телом (не висят)» — PASS_
- [x] В основной выдаче ровно одно связное твёрдое тело. _Топология: «Число твёрдых тел» — PASS; STEP: «Обратный импорт: одно твёрдое тело» — PASS; STL: «Одно связное тело» — PASS_
- [x] build123d/Python-скрипт выполнен без ошибок. _Построение: «build123d-скрипт выполнен без ошибок» — PASS; на macOS arm64 (машина пользователя); на Windows не запускался_
- [x] Положительный объём, валидный BREP, нет пересечений и щелей; методы записаны. _Топология: «Объём положительный» — PASS; Топология: «BRepCheck_Analyzer» — PASS; Топология: «Нет самопересечений/малых рёбер (BRepAlgoAPI_Check)» — PASS; Топология: «Свободные рёбра (щели в оболочке)» — PASS; Топология: «Неманифолдные рёбра» — PASS_
- [x] STEP не пустой, обратный импорт даёт ожидаемое твёрдое тело. _STEP: «Файл не пустой» — PASS; STEP: «Обратный импорт: валидность» — PASS; STEP: «Единицы — миллиметры» — PASS_
- [x] STL не пустой, ориентирован, замкнут и многообразен (проверено инструментально); мм отмечены для печатника. _STL: «Файл не пустой» — PASS; STL: «Замкнутость (watertight)» — PASS; STL: «Согласованная ориентация треугольников» — PASS; STL: «Нормали наружу (положительный объём)» — PASS; STL: «manifold3d: многообразная сетка» — PASS; единицы мм — reports/print_handoff.md_
- [x] STEP и STL из одной геометрии; записаны габариты, объём, число тел, параметры триангуляции. _STEP: «Объём совпадает с построением» — PASS; STEP: «Габариты совпадают с построением» — PASS; STL: «Объём STL ≈ объём CAD» — PASS; STL: «Габариты STL ≈ CAD (единицы мм)» — PASS_
- [x] Деталь визуально сопоставлена с основными фотографиями. _вручную — reports/figures/compare_*.png; расхождения перечислены в «Ручные проверки»_
- [x] Рабочее зацепление не объявлено подтверждённым без ответной части или испытания. _Зуб: «Удерживающая ступенька» — NOT CONFIRMED; статус NOT CONFIRMED; также в assumptions.md и print_handoff.md_

## Источники

| Проверка | Способ | Измерено | Ожидается | Допуск | Статус | Примечание |
|---|---|---:|---:|---:|---|---|
| SHA-256 input/cad-latch-spec(1).md | sha256 файлов input/ против INPUT_SHA256.md | да | да |  | **PASS** | совпадает с input/cad-latch-spec.md (имя файла без «(1)») |
| SHA-256 input/cad-photo-atlas(1).pdf | sha256 файлов input/ против INPUT_SHA256.md | да | да |  | **PASS** | совпадает с input/cad-photo-atlas.pdf (имя файла без «(1)») |

## Построение

| Проверка | Способ | Измерено | Ожидается | Допуск | Статус | Примечание |
|---|---|---:|---:|---:|---|---|
| build123d-скрипт выполнен без ошибок | model.build() в этом процессе | да | да |  | **PASS** | 10.07 с |
| Скругление/фаска: lug roots | журнал build(): операция выполнена, тело валидно после неё | да | да |  | **PASS** | R/фаска 0.5, рёбер 4 |
| Скругление/фаска: tooth upper root | журнал build(): операция выполнена, тело валидно после неё | да | да |  | **PASS** | R/фаска 1.0, рёбер 1 |
| Скругление/фаска: paddle root | журнал build(): операция выполнена, тело валидно после неё | да | да |  | **PASS** | R/фаска 1.0, рёбер 8 |
| Скругление/фаска: rib roots | журнал build(): операция выполнена, тело валидно после неё | да | да |  | **PASS** | R/фаска 0.5, рёбер 12 |
| Скругление/фаска: hole edges | журнал build(): операция выполнена, тело валидно после неё | да | да |  | **PASS** | R/фаска 0.2, рёбер 4 |

## Топология

| Проверка | Способ | Измерено | Ожидается | Допуск | Статус | Примечание |
|---|---|---:|---:|---:|---|---|
| Число твёрдых тел | len(solids()) | 1 шт | 1 | 0 | **PASS** |  |
| Число оболочек (нет внутренних пустот) | len(shells()) | 1 шт | 1 | 0 | **PASS** |  |
| BRepCheck_Analyzer | OCCT BRepCheck_Analyzer.IsValid | да | да |  | **PASS** |  |
| Нет самопересечений/малых рёбер (BRepAlgoAPI_Check) | OCCT BRepAlgoAPI_Check(тест малых рёбер, тест самопересечений) | да | да |  | **PASS** |  |
| Свободные рёбра (щели в оболочке) | рёбра с одной смежной гранью, кроме швов замкнутых поверхностей | 0 шт | 0 | 0 | **PASS** | швов цилиндров/конусов: 0 |
| Неманифолдные рёбра | рёбра с >2 смежными гранями | 0 шт | 0 | 0 | **PASS** |  |
| Объём положительный | solid.volume | 11008.4 мм³ |  |  | **PASS** |  |
| Минимальная длина ребра | min(edge.length) | 0.042 мм |  |  | **PASS** | порог 0,01 мм |
| Минимальная площадь грани | min(face.area) | 0.0317 мм² |  |  | **PASS** | порог 0,001 мм² |
| Граней / рёбер | подсчёт | 162 шт |  |  | **INFO** | рёбер 419 |

## Главные размеры

| Проверка | Способ | Измерено | Ожидается | Допуск | Статус | Примечание |
|---|---|---:|---:|---:|---|---|
| H1 = 33,5: макушка проушины → нижняя кромка фланца вдоль H (=Z) | BRepExtrema: точки тела, ближайшие к касательным плоскостям Z=max и Z=min | 33.5 мм | 33.5 | 0.005 | **PASS** | верх (10.90; 0.00; 11.300) на проушине; низ (0.00; -9.29; -22.200) на тыльно-нижней кромке фланца |
| Верхняя точка H1 — макушка проушины | X верхней точки в пределах проушины | да | да |  | **PASS** |  |
| Нижняя точка H1 — фланец, не лопатка и не зуб | сравнение минимумов Z отдельных элементов до объединения | да | да |  | **PASS** | фланец -22.200; зуб -21.843; лопатка -14.915 |
| H3 = 11,3: от A до макушки проушины по нормали к A | Z макушки − Z плоской грани A (нормаль +Z, содержит начало координат под C) | 11.3 мм | 11.3 | 0.005 | **PASS** | Z(A) = 0.000000; расстояние A до начала координат 0.00e+00 |
| H2 = 16,5: собственная высота фланца вдоль F | тело переведено в локальную систему фланца (x=X, y=V вдоль F, z=N); экстремумы V в слое пластины; низ — вершина выпуклой кромки, верх — прямая кончиков крылышек (X 19…37) | 16.5 мм | 16.5 | 0.005 | **PASS** | V_max=16.5000, V_min(крылышко)=-0.0000 |
| L1 = 30,0: от S до крайней точки свободного торца вдоль P | S — линия выхода верхней грани лопатки (P) из лицевой плоскости фланца (виртуальная острая кромка); крайняя точка — BRepExtrema к плоскости ⟂P | 30 мм | 30 | 0.005 | **PASS** | S=(Y -7.617; Z -9.002); крайняя точка X=11.802 |

## Проушины

| Проверка | Способ | Измерено | Ожидается | Допуск | Статус | Примечание |
|---|---|---:|---:|---:|---|---|
| Сечение по X над отверстием: два интервала | прямая вдоль X при Y=0, Z=9.85 | 2 шт | 2 | 0 | **PASS** | [(-13.9, -10.9), (10.9, 13.9)] |
| Чистый зазор между внутренними гранями 21,8 | b0 − a1 по той же прямой | 21.8 мм | 21.8 | 0.002 | **PASS** |  |
| Толщина проушины (−X) 3,0 | a1 − a0 | 3 мм | 3 | 0.002 | **PASS** |  |
| Толщина проушины (+X) 3,0 | b1 − b0 | 3 мм | 3 | 0.002 | **PASS** |  |
| Наружный размах 27,8 (Р) | b1 − a0 | 27.8 мм | 27.8 | 0.002 | **PASS** |  |
| Средние плоскости ±12,4 (Р) | (a0+a1)/2, (b0+b1)/2 | 12.4 мм | 12.4 | 0.002 | **PASS** | −X: -12.400 |
| Отверстия сквозные по оси C | прямая вдоль X по оси Y=0, Z=6.85 не пересекает тело | 0 интервалов | 0 | 0 | **PASS** |  |
| Отверстия: по одной цилиндрической грани в каждой проушине | вогнутые грани-цилиндры с осью ∥X в пределах толщин проушин | 2 шт | 2 | 0 | **PASS** | стороны X: [-1, 1]; выпуклых дуг вершины ушка: 2 |
| Диаметр отверстий Ø3,1 (грани-цилиндры, обе проушины) | 2 × радиус граней | 3.1 мм | 3.1 | 1.00e-06 | **PASS** | исправленный замер владельца (ранее Ø2,5) |
| Соосность отверстий (отклонение осей от C) | расстояние осей цилиндров до линии Y=0, Z=6.85 | 0 мм | 0 | 1.00e-06 | **PASS** |  |
| Центр отверстия над A = 6,85 (Р) | Z оси цилиндров − Z(A) | 6.85 мм | 6.85 | 1.00e-06 | **PASS** | H3 − (перемычка + Ø/2) |
| Перемычка над отверстием 2,9 | Z макушки − (Z оси + R) | 2.9 мм | 2.9 | 0.002 | **PASS** |  |
| Диаметр отверстий Ø3,1 (лучи в средних плоскостях проушин) | просвет между интервалами тела вдоль Z и вдоль Y через ось C, X = ±12,4 | 3.1 мм | 3.1 | 0.002 | **PASS** | 3.1000; 3.1000; 3.1000; 3.1000 |
| Основание ушка вдоль Y (у A, Z=0,05) | прямая вдоль Y в средней плоскости проушины | 10.4887 мм | 10.4887 | 0.002 | **PASS** | Д: касательные к дуге R4.45, развал боковин 6.43° |

## Площадка

| Проверка | Способ | Измерено | Ожидается | Допуск | Статус | Примечание |
|---|---|---:|---:|---:|---|---|
| Ширина площадки у торца рожков 30,8 | прямая вдоль X при Y=5.20, середина толщины | 30.809 мм | 30.809 | 0.002 | **PASS** | номинал 30.8 на самом торце |
| Ширина площадки у перехода к шейке 32,68 | прямая вдоль X при Y=-5.20, середина толщины | 32.671 мм | 32.671 | 0.002 | **PASS** | номинал 32.68 на самом торце |
| Длина площадки 10,5 в плоскости A | прямая вдоль Y при X=5, Z=−1,25 | 10.5 мм | 10.5 | 0.002 | **PASS** |  |
| Толщина площадки 2,5 | прямая вдоль Z при X=5, Y=0 (первый интервал) | 2.5 мм | 2.5 | 0.002 | **PASS** |  |

## Рожки

| Проверка | Способ | Измерено | Ожидается | Допуск | Статус | Примечание |
|---|---|---:|---:|---:|---|---|
| Количество рожков | прямая вдоль X через рожки | 2 шт | 2 | 0 | **PASS** |  |
| Межцентровое расстояние 18,0 | разность центров интервалов | 18 мм | 18 | 0.002 | **PASS** |  |
| Ширина рожка 2,2 | длина интервала | 2.2 мм | 2.2 | 0.002 | **PASS** |  |
| Вылет рожков за торец 2,0 | конец интервала по Y − Y торца площадки | 2 мм | 2 | 0.002 | **PASS** |  |

## Шейка

| Проверка | Способ | Измерено | Ожидается | Допуск | Статус | Примечание |
|---|---|---:|---:|---:|---|---|
| Итоговая длина шейки по лицевой грани (Р, из H1) | от нижнего лицевого угла площадки до прямой V=0 вдоль шейки | 3.4195 мм |  |  | **INFO** | стартовое значение исходника 5.1 подчинено H1 (ТЗ §10.2) |
| Длина шейки по тыльной грани (Р) | от низа площадки до прямой V=0 | 4.5842 мм |  |  | **INFO** |  |
| Ширина шейки у площадки | прямая вдоль X в середине толщины, V=-3.370 | 32.6993 мм | 32.6993 | 0.002 | **PASS** | линейный переход 32,68 → 34,0 (И) |
| Ширина шейки над переходом к фланцу | прямая вдоль X в середине толщины, V=-1.261 | 33.513 мм | 33.513 | 0.002 | **PASS** | линейный переход 32,68 → 34,0 (И) |
| Вогнутый переход шейки к прямой V=0 (ширина сопряжения 36) | ширина при V=-0.02 против расчёта дуги R1.211, касательной к V=0 в X=±18 | 35.5616 мм | 35.5616 | 0.005 | **PASS** |  |
| Лицевая грань шейки в одной плоскости с лицевой гранью фланца | точки ±0,01 мм от лицевой плоскости фланца в середине шейки: внутри/снаружи | да | да |  | **PASS** |  |

## Рёбра

| Проверка | Способ | Измерено | Ожидается | Допуск | Статус | Примечание |
|---|---|---:|---:|---:|---|---|
| Количество рёбер (раздельные, в центре треугольника профиля) | прямая вдоль X через центр профиля | 3 шт | 3 | 0 | **PASS** | X=-13.00 t=2.000; X=0.00 t=2.000; X=13.00 t=2.000 |
| Толщина рёбер 2,0 | максимальное отклонение длины интервала | 0 мм | 0 | 0.002 | **PASS** |  |
| Положение рёбер X = −13 / 0 / +13 | центры интервалов | 0 мм | 0 | 0.002 | **PASS** |  |
| Рёбра объединены с телом (не висят) | одно тело + наличие материала в центре каждого ребра | да | да |  | **PASS** |  |

## Фланец

| Проверка | Способ | Измерено | Ожидается | Допуск | Статус | Примечание |
|---|---|---:|---:|---:|---|---|
| Полная ширина 70 (после скругления кончиков R1) | габарит по X (BRepExtrema/bbox) | 70 мм | 70 | 0.002 | **PASS** |  |
| Толщина пластины 3,2 | прямая вдоль N в крылышке (X=30, V=2) | 3.2 мм | 3.2 | 0.002 | **PASS** |  |
| Контур проходит через опорную точку (X=0; V=16.5) | прямая вдоль F в середине толщины; крайний V = выпуклая кромка | 16.5 мм | 16.5 | 0.002 | **PASS** |  |
| Контур проходит через опорную точку (X=9; V=16.2) | прямая вдоль F в середине толщины; крайний V = выпуклая кромка | 16.2 мм | 16.2 | 0.002 | **PASS** |  |
| Контур проходит через опорную точку (X=18; V=14.3) | прямая вдоль F в середине толщины; крайний V = выпуклая кромка | 14.3 мм | 14.3 | 0.002 | **PASS** |  |
| Контур проходит через опорную точку (X=26; V=9.8) | прямая вдоль F в середине толщины; крайний V = выпуклая кромка | 9.8 мм | 9.8 | 0.002 | **PASS** |  |
| Выпуклая кромка без перегибов и волн | вторые разности V(X) на шаге 1 мм, X∈[−33;33] | -0.0024 мм |  |  | **PASS** | все вторые разности < 0; диапазон -0.0484…-0.0024 |
| Симметрия контура относительно B | max |V(X) − V(−X)| | 0 мм | 0 | 1.00e-04 | **PASS** |  |
| Нет общего R27: радиус кривизны у вершины | 1/|V''| в вершине | 423.8772 мм |  |  | **PASS** | сплайн по точкам ТЗ §12.1; R27 не задан ни на одном участке |
| Противоположная кромка — прямая V=0 | начало интервала вдоль F при X=±25 | 0 мм | 0 | 0.002 | **PASS** |  |

## Углубление

| Проверка | Способ | Измерено | Ожидается | Допуск | Статус | Примечание |
|---|---|---:|---:|---:|---|---|
| Глубина 1,5 (дно 1,7) | прямая вдоль N через центр углубления: тыльная граница | 1.5 мм | 1.5 | 0.002 | **PASS** | остаток стенки 1.700 |
| Длина 48 с закрытыми концами | прямая вдоль X внутри углубления: длина разрыва | 48 мм | 48 | 0.002 | **PASS** | материал по обе стороны — концы закрыты |
| Ширина 2,5 | прямая вдоль F внутри углубления | 2.5 мм | 2.5 | 0.002 | **PASS** |  |

## Лопатка

| Проверка | Способ | Измерено | Ожидается | Допуск | Статус | Примечание |
|---|---|---:|---:|---:|---|---|
| Толщина при u=5 от S (6 → 3 линейно) | прямая по нормали к P при X=0 | 5.5 мм | 5.5 | 0.002 | **PASS** |  |
| Толщина при u=15 от S (6 → 3 линейно) | прямая по нормали к P при X=0 | 4.5 мм | 4.5 | 0.002 | **PASS** |  |
| Толщина при u=25 от S (6 → 3 линейно) | прямая по нормали к P при X=0 | 3.5 мм | 3.5 | 0.002 | **PASS** |  |
| Ширина при u=5 (52 у S → 40 у конца) | прямая вдоль X в середине толщины (до начала дуг R10) | 50 мм | 50 | 0.002 | **PASS** |  |
| Ширина при u=15 (52 у S → 40 у конца) | прямая вдоль X в середине толщины (до начала дуг R10) | 46 мм | 46 | 0.002 | **PASS** |  |
| Ширина при u=20 (52 у S → 40 у конца) | прямая вдоль X в середине толщины (до начала дуг R10) | 44 мм | 44 | 0.002 | **PASS** |  |
| Углы свободного конца R10 в плане | ширина в 0,5 мм от торца против расчёта дуги R10, касательной к торцу и боковине | 29.8489 мм | 29.8489 | 0.01 | **PASS** |  |
| Голый корень лопатки (без галтели) внутри контура фланца | V кромки фланца при X = полуширине корня − V нижней линии корня (≈ без скругления R1,4) | 0.4477 мм |  |  | **PASS** | угол корня X=±25.58, V=9.66 |
| Галтель корня лопатки не выходит за контур фланца | сечения STL плоскостями ∥ лицевой на 0,05/0,3/0,8 мм перед ней: max(V − V_кромки) | -0.5399 мм |  |  | **PASS** | у нижних углов корня (|X|>23,5) галтель R1 сливается со скруглением кромки R0,5 — допущение V01 |

## Углы

| Проверка | Способ | Измерено | Ожидается | Допуск | Статус | Примечание |
|---|---|---:|---:|---:|---|---|
| α лопатка–фланец ≈110° | луч по верхней грани P к свободному концу ↔ луч по лицевой грани фланца к его верхней кромке (нормали реальных граней) | 110 ° | 110 | 1.00e-06 | **PASS** | сторона: верх фланца наклонён к +Y (к рожкам); δ=0.0 |
| β площадка–шейка ≈110° | луч по A к рожкам ↔ луч по лицевой грани шейки к фланцу | 110 ° | 110 | 1.00e-06 | **PASS** | тупой угол, шейка уходит вниз-к лопатке (−Y) |
| Наклон F к H | угол между лучом шейки/фланца вниз и −Z | 20 ° | 20 | 1.00e-06 | **PASS** | Р: α + δ − 90° |
| γ зуб–P = 0° (зуб не загнут) | угол между нормалями прямой грани зуба и верхней грани лопатки | 0 ° | 0 | 1.00e-06 | **PASS** |  |
| δ A–P = 0° | угол между нормалями A и P | 0 ° | 0 | 1.00e-06 | **PASS** |  |

## Зуб

| Проверка | Способ | Измерено | Ожидается | Допуск | Статус | Примечание |
|---|---|---:|---:|---:|---|---|
| Ширина 17,5, симметрично B | прямая вдоль X через тело зуба | 17.5 мм | 17.5 | 0.002 | **PASS** | центр X=0.0000 |
| Вылет 10,0 вдоль направления зуба | от линии корня прямой грани до торца (прямая ∥ зубу) | 10 мм | 10 | 0.002 | **PASS** | отсчёт от тыльной плоскости фланца на уровне прямой грани |
| Толщина в 3 мм от корня прямой грани | прямая по нормали к P | 3.8835 мм | 3.8835 | 0.002 | **PASS** | клин 5,2 у нижней линии корня → 2,0 у конца |
| Толщина в 6 мм от корня прямой грани | прямая по нормали к P | 3.0763 мм | 3.0763 | 0.002 | **PASS** | клин 5,2 у нижней линии корня → 2,0 у конца |
| Толщина в 9.5 мм от корня прямой грани | прямая по нормали к P | 2.1345 мм | 2.1345 | 0.002 | **PASS** | клин 5,2 у нижней линии корня → 2,0 у конца |
| Отступ корня от выпуклой кромки вдоль F (X=0) | H2 − V нижней линии корня | 0.5 мм | 0.5 | 1.00e-09 | **PASS** |  |
| Положение корня прямой грани относительно C | ΔY, ΔZ от оси C | -6.9922 мм |  |  | **INFO** | ΔY=-6.99 (к лопатке <0), ΔZ=-23.49; конец ΔY=3.01 |
| Сверка с фото-оценкой ТЗ §12.3 (≈26 ниже C; 5–6 к лопатке; ± несколько мм) | середина корня относительно C | 26.0928 мм |  |  | **INFO** | ниже C на 26.1; к лопатке на 7.9 — в пределах заявленной неопределённости фото |
| Удерживающая ступенька | параметр TOOTH_STEP_ENABLED | нет | нет |  | **NOT CONFIRMED** | форма/положение не измерены ('?'); механизм параметрический, по умолчанию выключен |

## STEP

| Проверка | Способ | Измерено | Ожидается | Допуск | Статус | Примечание |
|---|---|---:|---:|---:|---|---|
| Файл не пустой | размер файла | 822523 байт |  |  | **PASS** |  |
| Обратный импорт: одно твёрдое тело | import_step → solids() | 1 шт | 1 | 0 | **PASS** |  |
| Обратный импорт: валидность | BRepCheck_Analyzer | да | да |  | **PASS** |  |
| Объём совпадает с построением | |V_step − V_build| / V_build | 3.43e-06 отн. | 0 | 1.00e-05 | **PASS** | V_step=11008.329 мм³ |
| Габариты совпадают с построением | max |Δ bbox| | 1.00e-07 мм | 0 | 1.00e-04 | **PASS** |  |
| Единицы — миллиметры | SI_UNIT(.MILLI.,.METRE.) в заголовке STEP | да | да |  | **PASS** |  |
| Схема STEP | FILE_SCHEMA | AUTOMOTIVE_DESIGN { 1 0 10303 214 1 1 1 1 } |  |  | **INFO** |  |

## STL

| Проверка | Способ | Измерено | Ожидается | Допуск | Статус | Примечание |
|---|---|---:|---:|---:|---|---|
| Файл не пустой | число треугольников | 87364 шт |  |  | **PASS** | триангуляция: допуск 0.01 мм, угловой 0.1 рад |
| Замкнутость (watertight) | trimesh.is_watertight | да | да |  | **PASS** |  |
| Граничные рёбра сетки (дыры) | рёбра, принадлежащие одному треугольнику | 0 шт | 0 | 0 | **PASS** |  |
| Неманифолдные рёбра сетки | рёбра, принадлежащие >2 треугольникам | 0 шт | 0 | 0 | **PASS** |  |
| Согласованная ориентация треугольников | trimesh.is_winding_consistent | да | да |  | **PASS** |  |
| Нормали наружу (положительный объём) | trimesh.volume > 0 | 11006.7 мм³ |  |  | **PASS** |  |
| Одно связное тело | trimesh.split | 1 шт | 1 | 0 | **PASS** |  |
| Объём STL ≈ объём CAD | |V_stl − V_cad| / V_cad | 1.48e-04 отн. | 0 | 0.002 | **PASS** | V_stl=11006.74 мм³ |
| Габариты STL ≈ CAD (единицы мм) | max |Δ bbox| | 0.0014 мм | 0 | 0.02 | **PASS** | X 69.999 × Y 44.867 × Z 33.498 мм |
| Эйлерова характеристика | V − E + F (2 − 2·род) | -2 |  |  | **INFO** | ожидается −2: два сквозных отверстия (род 2) |
| manifold3d: многообразная сетка | Manifold(mesh).status() == NoError | Error.NoError |  |  | **PASS** | род 2, объём 11006.74 |

## Варианты

| Проверка | Способ | Измерено | Ожидается | Допуск | Статус | Примечание |
|---|---|---:|---:|---:|---|---|
| Перестроение: удерживающая ступенька включена (значения-заглушки) | model.build({'TOOTH_STEP_ENABLED': True}) | да | да |  | **PASS** | V=10952.4 мм³; прямая грань за стенкой понижена на 0.800 (задано 0.8) |
| Перестроение: прямая грань зуба снизу | model.build({'TOOTH_FLAT_FACE': 'bottom'}) | да | да |  | **PASS** | V=10937.5 мм³ |
| Перестроение: контур фланца по исходной таблице §12.1 (S поднята до 2,5) | model.build({'FLANGE_CONTOUR_SOURCE': 'spec', 'PADDLE_S_V': 2.5}) | да | да |  | **PASS** | V=10894.6 мм³ |
| Перестроение: γ = 3° | model.build({'GAMMA_DEG': 3.0}) | да | да |  | **PASS** | V=11014.9 мм³ |
| Перестроение: центр C зафиксирован на 7,15 (как до исправления Ø) | model.build({'LUG_HOLE_CENTER_Z_FIXED': 7.15}) | да | да |  | **PASS** | V=10989.5 мм³; перемычка 2.600 (ожидается 2.600), Ø по лучу 3.100, центр Z=7.15 |

## Ручные проверки и осмотр

Ниже — проверки, выполненные вручную (осмотр изображений и сопоставление с источниками). Они дополняют
автоматическую таблицу выше и **не являются измерениями оригинала**.

### Источники

| Что проверено | Как | Результат |
|---|---|---|
| ТЗ `input/cad-latch-spec.md` прочитано полностью (разделы 1–13, включая 10, 12, 13) | чтение всех 302 строк | Размеры, статусы и допущения перенесены в `src/params.py` и `reports/assumptions.md` |
| Все 12 страниц `input/cad-photo-atlas.pdf` | страницы отрендерены в PNG (pypdfium2), 10 встроенных фото извлечены в исходном разрешении и осмотрены; текст подписей сверен | Сделано. Отдельных JPG в пакете нет — только фото внутри PDF |
| Боковой вид, разметка H1/H2, участки углов (фото 03, 08, 09, 10) | увеличенные фрагменты IMG_4391/4394/4395/4396 с координатной сеткой; отрезки ТЗ §10.1 нанесены на IMG_4396 | Подтверждено: H1 — макушка → самая нижняя кромка фланца; H2 — вдоль наклона фланца; верх фланца наклонён к рожкам (+Y); лопатка уходит к −Y на середине высоты фланца |
| Вид с тыла (фото 06, IMG_4397) | извлечение силуэта выпуклой кромки, нормировка на 70 / 16,5 | Силуэт полнее табличных точек ТЗ у крылышек → точки ±18 и ±26 уточнены (см. assumptions.md) |
| Повреждённый зуб (фото 03, 04, 05, 07) | увеличенные фрагменты IMG_4391, IMG_4393 | Остаток зуба: верхняя грань почти параллельна лопатке, низ скошен к концу; в торце две полости с перемычкой; зуб обломан (видимый вылет ≈3,5 мм) |
| Отверстие проушины на IMG_4396 (13.11.2026, после исправления Ø владельцем) | окружность по 70 точкам кромки видимого просвета (МНК, СКО 0,8 px); масштаб H1: 765 px = 33,5 мм | Видимый просвет ≈2,8 мм, наружный обод с фаской ≈3,5 мм — согласуется с Ø3,1; Ø2,5 меньше видимого просвета. Высота центра под макушкой по фото 3,9–4,4 мм (зависит от выбранного обода) — разницу 6,85 / 7,15 (0,3 мм ≈ 7 px) перспективное фото не разрешает |

### Визуальное сопоставление модели с фото

Рисунки: `reports/figures/compare_*.png`; виды модели: `output/armrest_latch_v03_*.png`.

| Сравнение | Что совпадает | Расхождения / замечания |
|---|---|---|
| `compare_side_overlay_IMG_4396.png`: контур V01 наложен на IMG_4396 в масштабе H1 (765 px = 33,5 мм), привязка по макушке проушины и столбцу оси C (высота центра отверстия под фото не подгоняется), поворот кадра 4,3° по площадке | проушина и отверстие (**окружность Ø3,1 ложится на обод отверстия на фото, дуга R4,45 повторяет силуэт вершины**), площадка, рожок, треугольное ребро под площадкой, наклон шейки/фланца (сторона наклона верная), сопряжение лопатки и точка S, нижняя кромка фланца, положение зуба на тыльной стороне у нижней кромки; **верхняя грань остатка зуба лежит на прямой грани зуба V01** | на фото тыльная боковина проушины ближе к вертикали и не доходит до торца площадки со стороны рожков (≈1–1,5 мм) — в V01 принято допущение ТЗ §12.2 (основание 10,5 заподлицо с торцами); линия лопатки на фото наклонена к площадке ≈2° (в V01 δ = 0 по ТЗ); перспектива увеличивает ближнюю проушину и ширину полосы фланца. В редакции 12.11 привязка оси C на фото была смещена на ≈19 px (0,8 мм) по горизонтали — исправлено 13.11 |
| `compare_rear_IMG_4397.png`: тыл фланца | контур крылышек и выпуклой кромки, длинное углубление (≈ на 1/3 высоты от прямой кончиков), зуб у вершины кромки, переход шейки с тремя рёбрами, рожки, проушины | нижние кромки крылышек на фото слегка опускаются к шейке; в V01 — общая прямая V = 0 (ТЗ §12.1). Маркировка и круглые следы не моделировались (ТЗ §11) |
| `compare_tooth_side_IMG_4393.png`: снизу со стороны зуба, вдоль фланца | дуга кромки фланца, сужение лопатки к концу и углы R10, два рожка позади зуба, зуб в центре кромки | зуб на фото обломан и полый (две полости); в V01 — сплошной восстановленный клин 10 мм (ТЗ §12.3 п.4) |
| `compare_front_IMG_6558.png`: лицевая сторона лопатки | широкая лопатка со скруглёнными углами, проушины у корня, крылышки по бокам | ракурс фото перспективный, сравнение только качественное |

### Осмотр геометрии на дефекты

| Что | Как | Результат |
|---|---|---|
| Стык шейки с площадкой | крупные рендеры (6 × 6 мм) с двух сторон | Остаются маленькие уступы ≈0,3 мм там, где скруглённые кромки шейки (R0,5 / R0,4) встречают острые углы площадки — косметика, тело валидно. Найденная ранее паразитная галтель на ребре «торец площадки — шейка» (ошибка выбора рёбер) устранена |
| Корень лопатки у выпуклой кромки | рендеры и сечения X = 22 / 24 / 25 / 26 мм | Галтель R1 корня у нижних углов лопатки (|X| > 23,5) сливается со скруглением кромки фланца R0,5; материал за контур фланца не выходит (см. авто-проверку «Галтель корня лопатки не выходит за контур фланца») |
| Кончики рожков | анализ STL (trimesh): изначально 8 оторванных треугольников в угловых сопряжениях трёх галтелей | Исправлено построением рожка: скруглённое сечение R0,4 + одна гладкая петля R0,3 на торце; STL замкнут, 0 граничных и 0 неманифолдных рёбер |
| Рёбра, углубление, отверстия, зуб | рендеры `iso_rear`, `rear`, `side`, чертёж | Рёбра — отдельные треугольные косынки, сросшиеся с телом; углубление закрыто с обоих концов и не сквозное; отверстия соосны и сквозные; зуб прямой, без загиба |

### Что НЕ проверено (и не может быть проверено по имеющимся данным)

- Посадка на ось, зазор проушин относительно ответной бобышки крышки, свободный ход ручки.
- Положение, высота и угол **удерживающей грани зуба**, усилие защёлкивания и выхода из зацепления — нет ответной детали и замеров (ТЗ §9, §12.3).
- Прочность, усталость, нагрев в салоне, анизотропия печати — расчёты и испытания не выполнялись.
- Реальная печать: файлы в слайсере не открывались, G-code не создавался (ТЗ/AGENTS.md: без модели принтера и профиля — запрещено).
