etonealbert/frontier-navara-alaskan-latch/(commit log)

2026-11-14 Add V01 parametric build123d model of the armrest latch
    Full preliminary (fit-check) reconstruction per input/cad-latch-spec.md and
    the photo atlas: two lugs with coaxial 2.5 mm holes, pad with horns, neck with
    three ribs, flange with wings and a closed rear groove, tapered paddle, and a
    restored straight tooth parallel to the paddle plane.
    - src/: params.py (every value tagged with its spec status), model.py (build
    and STEP/STL export from one solid), validate.py (112 automated checks),
    render.py, drawing.py, compare_photos.py, run_all.py
    - output/: armrest_latch_v01.step and .stl (mm), 7 views, dimensioned drawing
    - reports/: validation (0 FAIL), assumptions, parameters, print handoff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
    [armrest_latch_v01.step, armrest_latch_v01.stl]
2026-11-14 Correct lug pivot holes to Ø3.1 per owner's corrected measurement
    The previous Ø2.5 (spec value "И") was a wrong measurement; the owner
    re-measured Ø3.1. LUG_HOLE_D is now 3.1 with status "У".
    Following the spec chain (§4, §10.2: centre = 11.3 − (2.9 + Ø/2)), the
    measured 2.9 mm wall above the hole is kept, so the pivot axis C moves
    from 7.15 to 6.85 mm above pad A and the lug top arc grows from R4.15 to
    R4.45. LUG_HOLE_CENTER_Z_FIXED = 7.15 keeps the old axis height instead
    (wall becomes 2.6); that variant is built and checked.
    - params.derived() now takes the build config, so overrides of lug values
    reach the derived positions (previously they were silently ignored)
    - the top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
    [armrest_latch_v01.step, armrest_latch_v01.stl]
2026-11-14 bumb version of .stl file
    [armrest_latch_v03.stl]
2026-11-14 Add English atlas and standardize V03 filenames
    [armrest_latch_v03.step]
